rgmabs19357/Hi3520D_V100R001C01SPC022/00.hardware/board/HI3520DDMEB_VER_B_BOM.xlsx

序号 | 描述 | 数量 | 单位 | 位号
8020107 | 固体SMD钽电容-25V-47uF-+/- | 6 | PCS | C1 C2 C3 C4 C5 C27
 | 20%-片状-7.3*4.3*2.8mm-
 | 普通(0.9ohm)
8020091 | 固体SMD钽电容-10V-100uF-+/- | 1 | PCS | C6
 | 20%-片状-7.3*4.3*3.1mm-
 | Low ESR(0.055ohm)-Polymer
8070730 | SMD陶瓷电容-25V-10000nF-- | 5 | PCS | C10 C11 C147 C148 C151
 | 20%~+80%-Y5V-1206
8070601 | SMD陶瓷电容-16V-1000nF-+/- | 3 | PCS | C12 C13 C257
 | 10%-X5R-0603
8070729 | SMD陶瓷电容-10V-10000nF-+/- | 1 | PCS | C14
 | 10%-X7R-1206
8070584 | SMD陶瓷电容-6.3V-220nF-+/- | 4 | PCS | C15 C39 C40 C41
 | 10%-X5R-0402-BT
8070235 | SMD陶瓷电容-50V-0.018nF-+/- | 2 | PCS | C16 C17
 | 5%-NPO-0603
8070667 | SMD陶瓷电容-6.3V-2200nF-+/- | 9 | PCS | C18 C19 C20 C21 C22 C23
 | 20%-X5R-0402-TS16949 |  |  | C24 C25 C26
8070680 | SMD陶瓷电容-6.3V-47000nF-+/- | 1 | PCS | C28
 | 20%-X5R-1206
8070614 | SMD陶瓷电容-16V-100nF-+/- | 107 | PCS | C29 C30 C31 C32 C33 C34
 | 10%-X7R-0402-BT |  |  | C35 C36 C37 C101 C102 C103
 |  |  |  | C104 C105 C106 C107 C277 C278
 |  |  |  | C115 C116 C117 C141 C142 C160
 |  |  |  | C161 C162 C183 C184 C185 C186
 |  |  |  | C188 C192 C210 C211 C212 C213
 |  |  |  | C214 C215 C236 C92 C93 C94
 |  |  |  | C95 C96 C97 C98 C99 C100
 |  |  |  | C237 C238 C252 C265 C266 C267
 |  |  |  | C268 C108 C109 C110 C111 C112
 |  |  |  | C113 C114 C65 C66 C67 C68
 |  |  |  | C69 C70 C71 C72 C73 C74
 |  |  |  | C75 C76 C77 C78 C79 C80
 |  |  |  | C81 C82 C83 C84 C85 C86
 |  |  |  | C87 C88 C89 C90 C91 C38
 |  |  |  | C46 C47 C50 C51 C52 C53
 |  |  |  | C54 C55 C56 C57 C58 C59
 |  |  |  | C60 C61 C62 C63 C64
8071114 | SMD陶瓷电容-6.3V-22000nF-+/- | 1 | PCS | C42
 | 20%-X5R-0805-
 | 08070784编码拆分供华为技术使
8070821 | SMD陶瓷电容-6.3V-10000nF-+/- | 5 | PCS | C43 C44 C45 C284 C285
 | 20%-X5R-0603
8070564 | SMD陶瓷电容-6.3V-4700nF-+/- | 4 | PCS | C48 C49 C226 C274
 | 20%-X5R-0603-BT,TS16949
8070561 | SMD陶瓷电容-10V-100nF-+/- | 25 | PCS | C118 C119 C120 C121 C122 C123
 | 10%-X5R-0402 |  |  | C124 C140 C239 C240 C276 C132
 |  |  |  | C133 C134 C135 C136 C137 C138
 |  |  |  | C125 C126 C127 C128 C129 C130
 |  |  |  | C131
8070279 | SMD陶瓷电容-50V-0.01nF-+/- | 6 | PCS | C139 C154 C293 C294 C295 C296
 | 0.25pF-NPO-0603
8070627 | SMD陶瓷电容-50V-100nF-+/- | 9 | PCS | C143 C144 C145 C146 C149 C150
 | 10%-X7R-0603 |  |  | C255 C256 C258
8070545 | SMD陶瓷电容-50V-0.022nF-+/- | 2 | PCS | C152 C153
 | 5%-NP0-0402-BT
8070262 | SMD陶瓷电容-16V-100nF-+/- | 9 | PCS | C155 C156 C157 C158 C159 C243
 | 10%-X7R-0603-TS16949 |  |  | C244 C245 C269
8070612 | SMD陶瓷电容-10V-1000nF-+/- | 22 | PCS | C163 C164 C165 C166 C167 C168
 | 10%-X5R-0402-BT,TS16949 |  |  | C169 C177 C264 C270 C271 C272
 |  |  |  | C273 C275 C170 C171 C172 C173
 |  |  |  | C174 C175 C176 C291
8070734 | SMD陶瓷电容-6.3V-100000nF- | 1 | PCS | C178
 | +/-20%-X5R-1206-TS16949
8070461 | SMD陶瓷电容-50V-0.027nF-+/- | 2 | PCS | C179 C180
 | 5%-NPO-0603
8070531 | SMD陶瓷电容-50V-1nF-+/-10%- | 3 | PCS | C187 C246 C253
 | X7R-0402-BT
8070439 | SMD陶瓷电容-2000V-1nF-+/- | 1 | PCS | C189
 | 20%-X7R-1206
8020132 | 固体SMD钽电容-6.3V-220uF-+/- | 4 | PCS | C190 C191 C193 C283
 | 20%-片式-3.5*2.8*1.9mm-
 | Low ESR(35mohm)-Polymer-
 | 供电专用
8070565 | SMD陶瓷电容-6.3V-10000nF-+/- | 2 | PCS | C194 C195
 | 10%-X5R-0805-TS16949
8020067 | 固体SMD钽电容-10V-100uF-+/- | 3 | PCS | C196 C197 C247
 | 20%-片状-7.3*4.3*2.8mm-
 | Low ESR(0.1ohm)
8070247 | SMD陶瓷电容-50V-10nF-+/-10%- | 12 | PCS | C198 C199 C200 C201 C202 C203
 | X7R-0603-TS16949 |  |  | C204 C205 C206 C207 C208 C209
8070649 | SMD陶瓷电容-6.3V-10000nF-+/- | 20 | PCS | C216 C217 C262 C263 C287 C288
 | 20%-X5R-0603-BT,TS16949 |  |  | C225 C248 C249 C250 C251 C260
 |  |  |  | C261 C218 C219 C220 C221 C222
 |  |  |  | C223 C224
8070609 | SMD陶瓷电容-50V-1.8nF-+/- | 9 | PCS | C227 C228 C229 C230 C231 C232
 | 10%-X7R-0402 |  |  | C233 C234 C235
8070449 | SMD陶瓷电容-16V-10nF-+/-10%- | 2 | PCS | C241 C242
 | X7R-0402-BT,TS16949
8071208 | SMD陶瓷电容-6.3V-47000nF-+/- | 1 | PCS | C254
 | 20%-X5R-0805
8020120 | 固体SMD钽电容-2.5V-220uF-+/- | 2 | PCS | C279 C280
 | 20%-片状-3.5*2.8*1.9mm-
 | Low ESR(35mohm)-Polymer
8070563 | SMD陶瓷电容-6.3V-2200nF-+/- | 2 | PCS | C281 C282
 | 10%-X5R-0603-BT
8070731 | SMD陶瓷电容-25V-10000nF-+/- | 1 | PCS | C286
 | 20%-X5R-1206
8070625 | SMD陶瓷电容-6.3V-470nF-+/- | 2 | PCS | C289 C290
 | 10%-X5R-0402
8070654 | SMD陶瓷电容-6.3V-100000nF- | 1 | PCS | C292
 | +/-20%-X5R-1210
15040152 | 瞬态抑制二极管-6V-12.5V- | 8 | PCS | D1 D2 D3 D4 D5 D6 D7 D8
 | 300W-10A-SOT23
15040135 | 瞬态抑制二极管-14.2V-15.8V- | 3 | PCS | D9 D10 D11
 | 300W-0A-SOT-23
15020097 | 红外遥控接收头-2.7~5.5V- | 1 | PCS | D17
 | 0.001A-0.015km-38kHz-940nm-
 | 6.95*6.0*5.6mm-
15040173 | 瞬态抑制二极管-17.1V-25.2V- | 1 | PCS | D18
 | 1500W-59.5A-SMC(DO-214AB)
15020062 | 发光二极管-0.015cd- | 3 | PCS | D19 D23 D24
 | 红色/630nm-15mA-0805
15040241 | 瞬态抑制二极管-350V-275V- | 1 | PCS | D20
 | 100A-SMB
15010042 | 开关二极管-70V-200mA-1.25V- | 2 | PCS | D21 D22
 | 6ns-串联-SOT-23-2 FIT
15010252 | 肖特基二极管-10V-3A-0.24V- | 1 | PCS | D25
 | SOD323-BT
19040108 | 保险管套件-快熔断-125V-5A- | 1 | PCS | F1
 | UL规格-0.016ohm-5.5A*A*Sec-
 | 有
14050006 | 插针-普通方脚插针-3PIN-单排- | 1 | PCS | J1
 | 直式-5.84mm-3.9mm-2.54mm-THT
14240065 | IO连接器-4+4Pin- | 1 | PCS | J2
 | 插座/侧面插入型-屏蔽-
 | A型USB插座
14160139 | 音视频连接器-RCA莲花插座- | 2 | PCS | J3 J4
 | 2PIN-弯母-THT-
 | 黄,从14160122中拆分,环保型号
 | 华技终端专用
14060040 | 电缆连接器-D-SUB型-15PIN- | 2 | PCS | J5 J6
 | 弯母-PCB焊接型-螺母UNC4-
 | 40,引脚长3.1mm-5A
14100075 | 普通插座-4PIN-单排-直式- | 1 | PCS | J7
 | 2.5mm-2mm-THT-3A
14190002 | 电源连接器-DC头-1PIN-50V- | 1 | PCS | J8
 | 0.5A-弯式-公座-焊接
DMEB00J9 | SATA数据连接器 | 2 | PCS | J9 J10
14200041 | 插座-电缆连接器-20PIN- | 1 | PCS | J11
 | 双直插座-2.54mm-9.3mm-2.9mm-
 | THT
14060132 | 电缆连接器-D型，三排-15PIN- | 1 | PCS | J12
 | 母座，弯脚-
 | PCB焊接型,螺母规格UNC4-40-
 | 引脚长3.2mm-
14080137 | 网口连接器-单排-单端口-8PIN- | 1 | PCS | J13
 | 8bit-非屏蔽-
 | 模型插座/侧面插入型-
 | 引脚长2.54mm-带固定脚/带灯
14060033 | 电缆连接器-D-SUB型-9PIN- | 1 | PCS | J14
 | 弯公-PCB焊接型-
 | 螺母规格UNC 4-
 | 40,引脚长3.1mm-5A
14050101 | 插针-普通方脚插针-1PIN-单排- | 4 | PCS | J15 J20 J21 J22
 | 直式-5.84mm-2.92mm-2.54mm-
 | THT
DMEB0J16 | HDMI连接器 | 1 | PCS | J16
14160126 | 音视频连接器-RCA莲花插座- | 1 | PCS | J17
 | 3PIN-弯母-PCB焊接型-
 | 黑,屏蔽/终端专用
DMEB0J18 | 2X16扣板连接器 | 2 | PCS | J18 J19
14100117 | 普通插座-4PIN-单排-直式- | 1 | PCS | J23
 | 5.08mm-2mm-THT-10A-(UL94V-0)
10031094 | 贴片电感器-4.7uH-+/-30%- | 4 | PCS | L1 L2 L3 L4
 | 0.032ohm-4A-30degC max-
 | 7.0*7.0*4.0mm-
 | 使用温度范围包括电感温升
10031213 | 贴片电感器-0.15uH-5%- | 3 | PCS | L5 L6 L7
 | 0.92ohm-0.28A-15degC-0603-
10070013 | EMI磁珠-+/-25%-600ohm- | 8 | PCS | LB1 LB2 LB3 LB4 LB13 LB14
 | 0.65ohm-0.2A- |  |  | LB15 LB16
10070008 | EMI磁珠-+/25%-100ohm-0.1ohm- | 4 | PCS | LB5 LB6 LB7 LB17
 | 0.9A-0805
10070014 | EMI磁珠-25%-600ohm-0.25ohm- | 2 | PCS | LB9 LB12
 | 0.5A-TS16949
10070019 | EMI磁珠-+/-25%-1000ohm- | 3 | PCS | LB10 LB11 LB18
 | 1.25ohm-0.25A-0402-
 | 1400ohm@1GHZ
10070003 | EMI磁珠-30ohm-0.05ohm-0.4A--603 | 1 | PCS | LB19
10070007 | EMI磁珠-±30%-600ohm- | 2 | PCS | LB20 LB21
 | 0.042ohm-3A-1210
10070012 | EMI磁珠-220ohm-0.05ohm-2A-805 | 1 | PCS | LB22
12010322 | 钟振-24MHz-+-50ppm--20degC- | 1 | PCS | OSC1
 | 70degC-3.3V-C-MOS-4pin/smd
15050086 | 三极管-NPN-40V-500mA-200mW- | 3 | PCS | Q1 Q2 Q3
 | 250mV-SC-59/sot-23-50
15060143 | MOSFET-N沟道-60V-0.115A- | 2 | PCS | Q5 Q6
 | 7500mohm-20V-SOT23
7090776 | 片式厚膜电阻器-0.0625W- | 17 | PCS | R1 R2 R3 R4 R5 R6 R7 R8
 | 49.9ohm-+/-1%-0402-BT |  |  | R9 R10 R11 R12 R13 R14 R15
 |  |  |  | R16 R17
7090803 | 片式厚膜电阻器-0.0625W- | 2 | PCS | R18 R73
 | 22ohm-+/-5%-0402-BT
7090603 | 片式厚膜电阻器-0.1W-100ohm- | 1 | PCS | R19
 | +/-1%-0603
7090937 | 片式厚膜电阻器-0.1W- | 2 | PCS | R20 R21
 | 27000ohm-+/-1%-0603
7090829 | 片式厚膜电阻器-0.0625W- | 2 | PCS | R22 R23
 | 47000ohm-+/-1%-0402
7090807 | 片式厚膜电阻器-0.0625W- | 2 | PCS | R24 R25
 | 100ohm-+/-5%-0402-BT
7091238 | 片式厚膜电阻器-0.1W- | 1 | PCS | R26
 | 75000ohm-+/-1%-0603
7090840 | 片式厚膜电阻器-0.0625W- | 3 | PCS | R27 R77 R104
 | 120ohm-+/-5%-0402
7090861 | 片式厚膜电阻器-0.0625W- | 5 | PCS | R28 R29 R30 R31 R32
 | 33ohm-+/-5%-0402-ELOM
7090836 | 片式厚膜电阻器-0.0625W- | 1 | PCS | R33
 | 33ohm-+/-1%-0402
7090247 | 片式厚膜电阻器-0.1W- | 4 | PCS | R34 R35 R50 R103
 | 10000ohm-+/-5%-0603-TS16949
7090857 | 片式厚膜电阻器-0.0625W- | 1 | PCS | R36
 | 1000000ohm-+/-1%-0402
7090800 | 片式厚膜电阻器-0.0625W-0ohm- | 10 | PCS | R37 R38 R39 R41 R42 R43
 | < 50mohm-0402-1A-BT |  |  | R45 R47 R198 R199
7091372 | 片式厚膜电阻器-0.0625W- | 1 | PCS | R48
 | 15000ohm-+/-1%-0402-BT
7090809 | 片式厚膜电阻器-0.0625W- | 4 | PCS | R49 R51 R52 R53
 | 1000ohm-+/-5%-0402-BT
7090548 | 片式厚膜电阻器-0.125W- | 2 | PCS | R55 R56
 | 8200ohm-+/-1%-0805
7090817 | 片式厚膜电阻器-0.0625W- | 2 | PCS | R57 R58
 | 12000ohm-+/-1%-0402
7090631 | 片式厚膜电阻器-0.1W-191ohm- | 2 | PCS | R59 R133
 | +/-1%-0603
7090634 | 片式厚膜电阻器-0.1W-43.2ohm- | 1 | PCS | R60
 | +/-1%-0603
7090815 | 片式厚膜电阻器-0.0625W- | 6 | PCS | R61 R62 R63 R65 R100 R146
 | 10000ohm-+/-5%-0402-BT
7090831 | 片式厚膜电阻器-0.0625W- | 5 | PCS | R68 R69 R70 R71 R72
 | 100000ohm-+/-5%-0402-BT
7090793 | 片式厚膜电阻器-0.0625W- | 6 | PCS | R74 R75 R76 R127 R128 R142
 | 4700ohm-+/-5%-0402-BT
7091321 | 片式厚膜电阻器-0.0625W- | 5 | PCS | R78 R79 R80 R81 R82
 | 75ohm-+/-1%-0402
7090610 | 片式厚膜电阻器-0.0625W- | 4 | PCS | R83 R84 R85 R86
 | 51ohm-+/-5%-0402
7090497 | 片式厚膜电阻器-0.1W-160ohm- | 1 | PCS | R89
 | +/-5%-0603
7090828 | 片式厚膜电阻器-0.0625W- | 2 | PCS | R90 R91
 | 33000ohm-+/-5%-0402
7090876 | 片式厚膜电阻器-0.0625W- | 8 | PCS | R92 R93 R94 R95 R96 R97
 | 24.9ohm-+/-1%-0402 |  |  | R98 R99
7090826 | 片式厚膜电阻器-0.1W-7680ohm- | 1 | PCS | R101
 | +/-1%-0603
7090246 | 片式厚膜电阻器-0.1W-4700ohm- | 3 | PCS | R102 R116 R117
 | +/-5%-0603-TS16949
7091376 | 片式厚膜电阻器-0.0625W- | 1 | PCS | R105
 | 24000ohm-+/-1%-0402
7090637 | 片式厚膜电阻器-0.1W-75ohm- | 6 | PCS | R106 R107 R108 R109 R110 R111
 | +/-5%-0603
7090253 | 片式厚膜电阻器-0.1W- | 1 | PCS | R115
 | 47000ohm-±5%-0603
7090277 | 片式厚膜电阻器-0.1W-1000ohm- | 5 | PCS | R118 R119 R123 R124 R130
 | +/-5%-0603-TS16949
7090941 | 片式厚膜电阻器-0.1W- | 1 | PCS | R120
 | 100000ohm-+/-1%-0603
7090643 | 片式厚膜电阻器-0.1W-2000ohm- | 6 | PCS | R121 R122 R125 R126 R139 R140
 | +/-5%-0603
7090522 | 片式厚膜电阻器-0.1W-0ohm- | 11 | PCS | R131 R150 R151 R152 R153 R154
 | <50mohm-0603-1A-BT,TS16949 |  |  | R155 R160 R161 R162 R163
7091421 | 片式厚膜电阻器-2W-0.001ohm- | 2 | PCS | R132 R149
 | +/-0.5%-2512-供电专用
7091641 | 片式厚膜电阻器-0.0625W- | 1 | PCS | R134
 | 39000ohm-+/-5%-0402--
 | 供电专用 07090912-供电专用
7091282 | 片式厚膜电阻器-0.0625W- | 4 | PCS | R135 R136 R137 R138
 | 1000ohm-+/-1%-0402-BT
7090784 | 片式厚膜电阻器-0.1W-2490ohm- | 1 | PCS | R145
 | +/-1%-0603
7090378 | 片式厚膜电阻器-0.1W-3010ohm- | 1 | PCS | R156
 | +/-1%-0603
7091782 | 片式厚膜电阻器-0.0625W- | 1 | PCS | R158
 | 240ohm-+/-1%-0402-BT
7090798 | 片式厚膜电阻器-0.0625W- | 4 | PCS | R159 R164 R165 R166
 | 22000ohm-+/-1%-0402
7090805 | 片式厚膜电阻器-0.0625W- | 4 | PCS | R170 R189 R193 R194
 | 47ohm-+/-5%-0402
7090266 | 片式厚膜电阻器-0.1W-51ohm- | 3 | PCS | R171 R172 R185
 | +/-5%-0603
7090821 | 片式厚膜电阻器-0.0625W- | 4 | PCS | R173 R174 R175 R176
 | 120000ohm-±5%-0402
7091388 | 片式厚膜电阻器-0.0625W- | 2 | PCS | R177 R178
 | 82000ohm-+/-1%-0402
7091345 | 片式厚膜电阻器-0.0625W- | 1 | PCS | R179
 | 750ohm-+/-1%-0402
7090269 | 片式厚膜电阻器-0.1W-100ohm- | 4 | PCS | R180 R181 R182 R183
 | +/-5%-0603
7090935 | 片式厚膜电阻器-0.1W- | 1 | PCS | R184
 | 40200ohm-+/-1%-0603
7090730 | 片式厚膜电阻器-0.0625W- | 1 | PCS | R186
 | 10ohm-+/-5%-0402
7090949 | 片式厚膜电阻器-0.1W-49.9ohm- | 1 | PCS | R187
 | +/-1%-0603
7091271 | 片式厚膜电阻器-0.0625W- | 1 | PCS | R188
 | 11000ohm-+/-1%-0402-BT
7091294 | 片式厚膜电阻器-0.1W-390ohm- | 1 | PCS | R190
 | +/-1%-0603
7090843 | 片式厚膜电阻器-0.0625W- | 2 | PCS | R195 R196
 | 470ohm-±5％-0402
7090531 | 片式厚膜电阻器-0.1W- | 1 | PCS | R197
 | 30100ohm-+/-1%-0603
7090275 | 片式厚膜电阻器-0.1W-470ohm- | 1 | PCS | R282
 | ±5%-0603
7080134 | 电阻网络-0.0625W-22ohm-4- | 4 | PCS | RN1 RN2 RN3 RN4
 | 8PIN-+/-5%-SMT-独立式-SMT-
 | 2*1*0.45-0.5mm
7080125 | 电阻网络-0.0625W-51ohm-4个- | 5 | PCS | RN5 RN6 RN7 RN8 RN9
 | 8PIN-+/-5%-SMT-小型-独立式-
 | 2.0*1.0*0.45-0.5mm
16100017 | 微动开关-SPST-12VDC-0.05A- | 1 | PCS | S1
 | SMT-0mm-6*6*5mm-100,000
9050085 | LAN变压器-1CT:1CT-0.35mH- | 1 | PCS | T1
 | 0uH-1路-2-100BASE-T接口模块-
 | SMT
39110429 | LDO-可调型-1%-TO-252&DPAK | 1 | PCS | U1
39070039 | Voltage Monitor-2.63V-220ms- | 1 | PCS | U2
 | 电压监测-1V-5.5V-SOT23-3-
 | push-pull output-终端专用
99051CSG | 单端HDMI传输保护接口器件 | 1 | PCS | U3
14190188 | 电源连接器-电池连接器-2PIN- | 1 | PCS | U4
 | 3V-0.265A-卧式-SMT
DMEB00U5 | SPI FLASH 16Mbit MX25L12835F | 1 | PCS | U5
38090077 | RS485｜422- | 1 | PCS | U6
 | RS485/422接口收发器-3.3V-
 | 12MB/s-SOIC8
99051CDK | video buff FM6143 | 1 | PCS | U7
DMEB00U8 | 主芯片HI3520D | 1 | PCS | U8
DMEB00U9 | AD芯片CX26828 | 1 | PCS | U9
40020109 | DDR3 DRAM-2Gbit-800MHz- | 1 | PCS | U10
 | 16bit-1.5V-FBGA96(无铅)
38090076 | RS232-2路收发器-3.0V~5.5V- | 1 | PCS | U11
 | SSOP16-0.25MB/s
99051MTD | MP1494DJ-LF-P | 3 | PCS | U14 U15 U12
12020001 | 晶体谐振器-0.032768MHz- | 1 | PCS | X1
 | 12.5pF-+/-20ppm-35000ohm-DT-38
12020090 | 晶体谐振器-24MHz-20pF-+/- | 1 | PCS | X2
 | 30ppm-40ohm-SMD
99051JTC | MP1495DJ-LF-P | 1 | PCS | U13
90010045 | 固体生产辅料-镀锡铜线- | 1 | CM | X1
 | D0.5mm-固定元件
无 | 印刷PCB-HI3520DDMEB VER.B | 1 | PCS | 无
