rgmabs19357/Hi3520D_V100R001C01SPC022/00.hardware/board/HI3520DDMEB_VER_B_BOM_EN.xlsx

SN | Description | Quantity | Position ID
8020107 | Solid SMD tantalum capacitor-25 V-47 uF-± | 6 | C1 C2 C3 C4 C5 C27
 | 20%-chip form-7.3 mm x 4.3 mm x 2.8 mm-
 | common (0.9 ohm)
8020091 | Solid SMD tantalum capacitor-10 V-100 uF-± | 1 | C6
 | 20%-chip form-7.3 mm x 4.3 mm x 3.1 mm-
 | Low ESR (0.055 ohm)-Polymer
8070730 | SMD ceramic capacitor-25 V-10000 nF-- | 5 | C10 C11 C147 C148 C151
 | 20% to +80%-Y5 V-1206
8070601 | SMD ceramic capacitor-16 V-1000 nF-± | 3 | C12 C13 C257
 | 10%-X5R-0603
8070729 | SMD ceramic capacitor-10 V-10000 nF-± | 1 | C14
 | 10%-X7R-1206
8070584 | SMD ceramic capacitor-6.3 V-220 nF-± | 4 | C15 C39 C40 C41
 | 10%-X5R-0402-BT
8070235 | SMD ceramic capacitor-50 V-0.018 nF-± | 2 | C16 C17
 | 5%-NPO-0603
8070667 | SMD ceramic capacitor-6.3 V-2200 nF-± | 9 | C18 C19 C20 C21 C22 C23
 | 20%-X5R-0402-TS16949 |  | C24 C25 C26
8070680 | SMD ceramic capacitor-6.3 V-47000 nF-± | 1 | C28
 | 20%-X5R-1206
8070614 | SMD ceramic capacitor-16 V-100 nF-± | 107 | C29 C30 C31 C32 C33 C34
 | 10%-X7R-0402-BT |  | C35 C36 C37 C101 C102 C103
 |  |  | C104 C105 C106 C107 C277 C278
 |  |  | C115 C116 C117 C141 C142 C160
 |  |  | C161 C162 C183 C184 C185 C186
 |  |  | C188 C192 C210 C211 C212 C213
 |  |  | C214 C215 C236 C92 C93 C94
 |  |  | C95 C96 C97 C98 C99 C100
 |  |  | C237 C238 C252 C265 C266 C267
 |  |  | C268 C108 C109 C110 C111 C112
 |  |  | C113 C114 C65 C66 C67 C68
 |  |  | C69 C70 C71 C72 C73 C74
 |  |  | C75 C76 C77 C78 C79 C80
 |  |  | C81 C82 C83 C84 C85 C86
 |  |  | C87 C88 C89 C90 C91 C38
 |  |  | C46 C47 C50 C51 C52 C53
 |  |  | C54 C55 C56 C57 C58 C59
 |  |  | C60 C61 C62 C63 C64
8071114 | SMD ceramic capacitor-6.3 V-22000 nF-± | 1 | C42
 | 20%-X5R-0805-
 | split from 08070784 for Huawei
8070821 | SMD ceramic capacitor-6.3 V-10000 nF-± | 5 | C43 C44 C45 C284 C285
 | 20%-X5R-0603
8070564 | SMD ceramic capacitor-6.3 V-4700 nF-± | 4 | C48 C49 C226 C274
 | 20%-X5R-0603-BT, TS16949
8070561 | SMD ceramic capacitor-10 V-100 nF-± | 25 | C118 C119 C120 C121 C122 C123
 | 10%-X5R-0402 |  | C124 C140 C239 C240 C276 C132
 |  |  | C133 C134 C135 C136 C137 C138
 |  |  | C125 C126 C127 C128 C129 C130
 |  |  | C131
8070279 | SMD ceramic capacitor-50 V-0.01 nF-± | 6 | C139 C154 C293 C294 C295 C296
 | 0.25pF-NPO-0603
8070627 | SMD ceramic capacitor-50 V-100 nF-± | 9 | C143 C144 C145 C146 C149 C150
 | 10%-X7R-0603 |  | C255 C256 C258
8070545 | SMD ceramic capacitor-50 V-0.022 nF-± | 2 | C152 C153
 | 5%-NP0-0402-BT
8070262 | SMD ceramic capacitor-16 V-100 nF-± | 9 | C155 C156 C157 C158 C159 C243
 | 10%-X7R-0603-TS16949 |  | C244 C245 C269
8070612 | SMD ceramic capacitor-10 V-1000 nF-± | 22 | C163 C164 C165 C166 C167 C168
 | 10%-X5R-0402-BT, TS16949 |  | C169 C177 C264 C270 C271 C272
 |  |  | C273 C275 C170 C171 C172 C173
 |  |  | C174 C175 C176 C291
8070734 | SMD ceramic capacitor-6.3 V-100000 nF- | 1 | C178
 | ±20%-X5R-1206-TS16949
8070461 | SMD ceramic capacitor-50 V-0.027 nF-± | 2 | C179 C180
 | 5%-NPO-0603
8070531 | SMD ceramic capacitor-50 V-1 nF-±10%- | 3 | C187 C246 C253
 | X7R-0402-BT
8070439 | SMD ceramic capacitor-2000 V-1 nF-± | 1 | C189
 | 20%-X7R-1206
8020132 | Solid SMD tantalum capacitor-6.3 V-220 uF-± | 4 | C190 C191 C193 C283
 | 20%-chip form-3.5 mm x 2.8 mm x 1.9 mm-
 | Low ESR (35 Mohms)-Polymer-
 | only for power supply
8070565 | SMD ceramic capacitor-6.3 V-10000 nF-± | 2 | C194 C195
 | 10%-X5R-0805-TS16949
8020067 | Solid SMD tantalum capacitor-10 V-100 uF-± | 3 | C196 C197 C247
 | 20%-chip form-7.3 mm x 4.3 mm x 2.8 mm-
 | Low ESR (0.1 ohm)
8070247 | SMD ceramic capacitor-50 V-10 nF-±10%- | 12 | C198 C199 C200 C201 C202 C203
 | X7R-0603-TS16949 |  | C204 C205 C206 C207 C208 C209
8070649 | SMD ceramic capacitor-6.3 V-10000 nF-± | 20 | C216 C217 C262 C263 C287 C288
 | 20%-X5R-0603-BT, TS16949 |  | C225 C248 C249 C250 C251 C260
 |  |  | C261 C218 C219 C220 C221 C222
 |  |  | C223 C224
8070609 | SMD ceramic capacitor-50 V-1.8 nF-± | 9 | C227 C228 C229 C230 C231 C232
 | 10%-X7R-0402 |  | C233 C234 C235
8070449 | SMD ceramic capacitor-16 V-10 nF-±10%- | 2 | C241 C242
 | X7R-0402-BT, TS16949
8071208 | SMD ceramic capacitor-6.3 V-47000 nF-± | 1 | C254
 | 20%-X5R-0805
8020120 | Solid SMD tantalum capacitor-2.5 V-220 uF-± | 2 | C279 C280
 | 20%-chip form-3.5 mm x 2.8 mm x 1.9 mm-
 | Low ESR (35 Mohms)-Polymer
8070563 | SMD ceramic capacitor-6.3 V-2200 nF-± | 2 | C281 C282
 | 10%-X5R-0603-BT
8070731 | SMD ceramic capacitor-25 V-10000 nF-± | 1 | C286
 | 20%-X5R-1206
8070625 | SMD ceramic capacitor-6.3 V-470 nF-± | 2 | C289 C290
 | 10%-X5R-0402
8070654 | SMD ceramic capacitor-6.3 V-100000 nF- | 1 | C292
 | ±20%-X5R-1210
15040152 | Transient suppression diode-6 V-12.5 V- | 8 | D1 D2 D3 D4 D5 D6 D7 D8
 | 300 W-10 A-SOT23
15040135 | Transient suppression diode-14.2 V-15.8 V- | 3 | D9 D10 D11
 | 300 W-0 A-SOT-23
15020097 | IR remote receiver-2.7 V to 5.5 V- | 1 | D17
 | 0.001 A-0.015 km-38 kHz-940 nm-
 | 6.95 mm x 6.0 mm x 5.6 mm-
15040173 | Transient suppression diode-17.1 V-25.2 V- | 1 | D18
 | 1500 W-59.5 A-SMC (DO-214 AB)
15020062 | Light emitting diode-0.015cd- | 3 | D19 D23 D24
 | red/630 nm-15 mA-0805
15040241 | Transient suppression diode-350 V-275 V- | 1 | D20
 | 100 A-SMB
15010042 | Switch diode-70 V-200 mA-1.25 V- | 2 | D21 D22
 | 6 ns-serial-SOT-23-2 FIT
15010252 | Schottky diode-10 V-3 A-0.24 V- | 1 | D25
 | SOD323-BT
19040108 | Fuse kit-fast fuse-125 V-5 A- | 1 | F1
 | UL specifications-0.016 ohm-5.5 A*A*Sec-
 | provided
14050006 | Pin-common quad pin-3-pin-single-row- | 1 | J1
 | in-line-5.84 mm-3.9 mm-2.54 mm-THT
14240065 | I/O connector-4+4-pin- | 1 | J2
 | connector/side entry-shield-
 | type-A USB connector
14160139 | Audio/Video connector-RCA connector- | 2 | J3 J4
 | 2-pin-right angle female-THT-
 | yellow, split from 14160122, environmental protection
 | dedicated for Huawei Device
14060040 | Cable connector-D-SUB type-15-pin- | 2 | J5 J6
 | right angle female-PCB soldering-nut UNC4-
 | 40, pin length of 3.1 mm-5 A
14100075 | Common connector-4-pin-single-row-in-line- | 1 | J7
 | 2.5 mm-2 mm-THT-3 A
14190002 | Power connector-DC header-1-pin-50 V- | 1 | J8
 | 0.5 A-right angle-male socket-soldering
DMEB00J9 | SATA data connector | 2 | J9 J10
14200041 | Connector-cable connector-20-pin- | 1 | J11
 | Dual-in-line connector-2.54 mm-9.3 mm-2.9 mm-
 | THT
14060132 | Cable connector-D type, three-row-15-pin- | 1 | J12
 | female connector, right angle-
 | PCB soldering, nut specifications UNC4-40-
 | pin length of 3.2 mm-
14080137 | Ethernet port connector-single-row-single-port-8-pin- | 1 | J13
 | 8-bit-non-shield-
 | model connector/side entry-
 | pin length of 2.54 mm-with fixing foot/indicator
14060033 | Cable connector-D-SUB type-9-pin- | 1 | J14
 | right angle male-PCB soldering-
 | nut specifications UNC 4-
 | 40, pin length of 3.1 mm-5 A
14050101 | Pin-common quad pin-1-pin-single-row- | 4 | J15 J20 J21 J22
 | in-line-5.84 mm-2.92 mm-2.54 mm-
 | THT
DMEB0J16 | HDMI connector | 1 | J16
14160126 | Audio/Video connector-RCA connector- | 1 | J17
 | 3-pin-right angle female-PCB soldering-
 | black, shield/dedicated for Huawei Device
DMEB0J18 | 2X16 daughter board connector | 2 | J18 J19
14100117 | Common connector-4-pin-single-row-in-line- | 1 | J23
 | 5.08 mm-2 mm-THT-10 A-(UL94 V-0)
10031094 | SMT inductor-4.7 uH-±30%- | 4 | L1 L2 L3 L4
 | 0.032 ohm-4 A-30ºC max-
 | 7.0 mm x 7.0 mm x 4.0 mm-
 | The working temperature range includes the risen temperature of the inductor.
10031213 | SMT inductor-0.15 uH-5%- | 3 | L5 L6 L7
 | 0.92 ohm-0.28 A-15ºC-0603-
10070013 | EMI bead-±25%-600 ohms- | 8 | LB1 LB2 LB3 LB4 LB13 LB14
 | 0.65 ohm-0.2 A- |  | LB15 LB16
10070008 | EMI bead-+/25%-100 ohms-0.1 ohm- | 4 | LB5 LB6 LB7 LB17
 | 0.9 A-0805
10070014 | EMI bead-25%-600 ohms-0.25 ohm- | 2 | LB9 LB12
 | 0.5 A-TS16949
10070019 | EMI bead-±25%-1000 ohms- | 3 | LB10 LB11 LB18
 | 1.25 ohm-0.25 A-0402-
 | 1400 ohms@1 GHz
10070003 | EMI bead-30 ohm-0.05 ohm-0.4 A--603 | 1 | LB19
10070007 | EMI bead-±30%-600 ohms- | 2 | LB20 LB21
 | 0.042 ohm-3 A-1210
10070012 | EMI bead-220 ohm-0.05 ohm-2 A-805 | 1 | LB22
12010322 | Clock oscillator-24 MHz-±50 ppm--20ºC- | 1 | OSC1
 | 70ºC-3.3 V-C-MOS-4-pin/smd
15050086 | Triode-NPN-40 V-500 mA-200mW- | 3 | Q1 Q2 Q3
 | 250 mV-SC-59/sot-23-50
15060143 | MOSFET-N channel-60 V-0.115 A- | 2 | Q5 Q6
 | 7500 Mohms-20 V-SOT23
7090776 | Thick film chip resistor-0.0625 W- | 17 | R1 R2 R3 R4 R5 R6 R7 R8
 | 49.9 ohms-±1%-0402-BT |  | R9 R10 R11 R12 R13 R14 R15
 |  |  | R16 R17
7090803 | Thick film chip resistor-0.0625 W- | 2 | R18 R73
 | 22 ohm-±5%-0402-BT
7090603 | Thick film chip resistor-0.1 W-100 ohms- | 1 | R19
 | ±1%-0603
7090937 | Thick film chip resistor-0.1 W- | 2 | R20 R21
 | 27000 ohms-±1%-0603
7090829 | Thick film chip resistor-0.0625 W- | 2 | R22 R23
 | 47000 ohms-±1%-0402
7090807 | Thick film chip resistor-0.0625 W- | 2 | R24 R25
 | 100 ohms-±5%-0402-BT
7091238 | Thick film chip resistor-0.1 W- | 1 | R26
 | 75000 ohms-±1%-0603
7090840 | Thick film chip resistor-0.0625 W- | 3 | R27 R77 R104
 | 120 ohm-±5%-0402
7090861 | Thick film chip resistor-0.0625 W- | 5 | R28 R29 R30 R31 R32
 | 33 ohm-±5%-0402-ELOM
7090836 | Thick film chip resistor-0.0625 W- | 1 | R33
 | 33 ohm-±1%-0402
7090247 | Thick film chip resistor-0.1 W- | 4 | R34 R35 R50 R103
 | 10000 ohms-±5%-0603-TS16949
7090857 | Thick film chip resistor-0.0625 W- | 1 | R36
 | 1000000 ohms-±1%-0402
7090800 | Thick film chip resistor-0.0625 W-0 ohms- | 10 | R37 R38 R39 R41 R42 R43
 | < 50 Mohms-0402-1 A-BT |  | R45 R47 R198 R199
7091372 | Thick film chip resistor-0.0625 W- | 1 | R48
 | 15000 ohms-±1%-0402-BT
7090809 | Thick film chip resistor-0.0625 W- | 4 | R49 R51 R52 R53
 | 1000 ohms-±5%-0402-BT
7090548 | Thick film chip resistor-0.125 W- | 2 | R55 R56
 | 8200 ohms-±1%-0805
7090817 | Thick film chip resistor-0.0625 W- | 2 | R57 R58
 | 12000 ohms-±1%-0402
7090631 | Thick film chip resistor-0.1 W-191 ohms- | 2 | R59 R133
 | ±1%-0603
7090634 | Thick film chip resistor-0.1 W-43.2 ohms- | 1 | R60
 | ±1%-0603
7090815 | Thick film chip resistor-0.0625 W- | 6 | R61 R62 R63 R65 R100 R146
 | 10000 ohms-±5%-0402-BT
7090831 | Thick film chip resistor-0.0625 W- | 5 | R68 R69 R70 R71 R72
 | 100000 ohms-±5%-0402-BT
7090793 | Thick film chip resistor-0.0625 W- | 6 | R74 R75 R76 R127 R128 R142
 | 4700 ohms-±5%-0402-BT
7091321 | Thick film chip resistor-0.0625 W- | 5 | R78 R79 R80 R81 R82
 | 75 ohms-±1%-0402
7090610 | Thick film chip resistor-0.0625 W- | 4 | R83 R84 R85 R86
 | 51 ohms-±5%-0402
7090497 | Thick film chip resistor-0.1 W-160 ohms- | 1 | R89
 | ±5%-0603
7090828 | Thick film chip resistor-0.0625 W- | 2 | R90 R91
 | 33000 ohms-±5%-0402
7090876 | Thick film chip resistor-0.0625 W- | 8 | R92 R93 R94 R95 R96 R97
 | 24.9 ohms-±1%-0402 |  | R98 R99
7090826 | Thick film chip resistor-0.1 W-7680 ohms- | 1 | R101
 | ±1%-0603
7090246 | Thick film chip resistor-0.1 W-4700 ohms- | 3 | R102 R116 R117
 | ±5%-0603-TS16949
7091376 | Thick film chip resistor-0.0625 W- | 1 | R105
 | 24000 ohms-±1%-0402
7090637 | Thick film chip resistor-0.1 W-75 ohms- | 6 | R106 R107 R108 R109 R110 R111
 | ±5%-0603
7090253 | Thick film chip resistor-0.1 W- | 1 | R115
 | 47000 ohms-±5%-0603
7090277 | Thick film chip resistor-0.1 W-1000 ohms- | 5 | R118 R119 R123 R124 R130
 | ±5%-0603-TS16949
7090941 | Thick film chip resistor-0.1 W- | 1 | R120
 | 100000 ohms-±1%-0603
7090643 | Thick film chip resistor-0.1 W-2000 ohms- | 6 | R121 R122 R125 R126 R139 R140
 | ±5%-0603
7090522 | Thick film chip resistor-0.1 W-0 ohms- | 11 | R131 R150 R151 R152 R153 R154
 | <50 Mohms-0603-1 A-BT, TS16949 |  | R155 R160 R161 R162 R163
7091421 | Thick film chip resistor-2 W-0.001 ohm- | 2 | R132 R149
 | ±0.5%-2512-only for power supply
7091641 | Thick film chip resistor-0.0625 W- | 1 | R134
 | 39000 ohms-±5%-0402--
 | only for power supply 07090912-only for power supply
7091282 | Thick film chip resistor-0.0625 W- | 4 | R135 R136 R137 R138
 | 1000 ohms-±1%-0402-BT
7090784 | Thick film chip resistor-0.1 W-2490 ohms- | 1 | R145
 | ±1%-0603
7090378 | Thick film chip resistor-0.1 W-3010 ohms- | 1 | R156
 | ±1%-0603
7091782 | Thick film chip resistor-0.0625 W- | 1 | R158
 | 240 ohms-±1%-0402-BT
7090798 | Thick film chip resistor-0.0625 W- | 4 | R159 R164 R165 R166
 | 22000 ohms-±1%-0402
7090805 | Thick film chip resistor-0.0625 W- | 4 | R170 R189 R193 R194
 | 47 ohm-±5%-0402
7090266 | Thick film chip resistor-0.1 W-51 ohm- | 3 | R171 R172 R185
 | ±5%-0603
7090821 | Thick film chip resistor-0.0625 W- | 4 | R173 R174 R175 R176
 | 120000 ohms-±5%-0402
7091388 | Thick film chip resistor-0.0625 W- | 2 | R177 R178
 | 82000 ohms-±1%-0402
7091345 | Thick film chip resistor-0.0625 W- | 1 | R179
 | 750 ohms-±1%-0402
7090269 | Thick film chip resistor-0.1 W-100 ohms- | 4 | R180 R181 R182 R183
 | ±5%-0603
7090935 | Thick film chip resistor-0.1 W- | 1 | R184
 | 40200 ohms-±1%-0603
7090730 | Thick film chip resistor-0.0625 W- | 1 | R186
 | 10 ohms-±5%-0402
7090949 | Thick film chip resistor-0.1 W-49.9 ohms- | 1 | R187
 | ±1%-0603
7091271 | Thick film chip resistor-0.0625 W- | 1 | R188
 | 11000 ohms-±1%-0402-BT
7091294 | Thick film chip resistor-0.1 W-390 ohms- | 1 | R190
 | ±1%-0603
7090843 | Thick film chip resistor-0.0625 W- | 2 | R195 R196
 | 470 ohm-±5%-0402
7090531 | Thick film chip resistor-0.1 W- | 1 | R197
 | 30100 ohms-±1%-0603
7090275 | Thick film chip resistor-0.1 W-470 ohms- | 1 | R282
 | ±5%-0603
7080134 | Resistor network-0.0625 W-22 ohms-4- | 4 | RN1 RN2 RN3 RN4
 | 8-pin-±5%-SMT-independent-SMT-
 | 2 x 1 x 0.45-0.5 mm
7080125 | Resistor network-0.0625 W-51 ohm-4- | 5 | RN5 RN6 RN7 RN8 RN9
 | 8PIN-±5%-SMT-mini-type-independent-
 | 2.0 x 1.0 x 0.45-0.5 mm
16100017 | Microswitch-SPST-12 VDC-0.05 A- | 1 | S1
 | SMT-0 mm-6 mm x 6 mm x 5 mm-100,000
9050085 | LAN transformer-1CT:1CT-0.35 mH- | 1 | T1
 | 0 uH-1-channel-2-100BASE-T interface module-
 | SMT
39110429 | LDO-adjustable-1%-TO-252&DPAK | 1 | U1
39070039 | Voltage monitor-2.63 V-220 ms- | 1 | U2
 | voltage monitoring-1 V-5.5 V-SOT23-3-
 | push-pull output-dedicated for Huawei Device
99051CSG | Single-end HDMI transfer protective component | 1 | U3
14190188 | Power connector-battery connector-2-pin- | 1 | U4
 | 3 V-0.265 A-horizontal type-SMT
DMEB00U5 | SPI flash 16-Mbit MX25L12835F | 1 | U5
38090077 | RS485|422- | 1 | U6
 | RS485/422 interface transceiver-3.3 V-
 | 12 MB/s-SOIC8
99051CDK | video buffer FM6143 | 1 | U7
DMEB00U8 | Master chip Hi3520D | 1 | U8
DMEB00U9 | ADC CX26828 | 1 | U9
40020109 | DDR3 DRAM-2 Gbits-800 MHz- | 1 | U10
 | 16-bit-1.5 V-FBGA96 (lead free)
38090076 | RS232-2-channel transceiver-3.0 V to 5.5 V- | 1 | U11
 | SSOP16-0.25 MB/s
99051MTD | MP1494DJ-LF-P | 3 | U14 U15 U12
12020001 | Crystal resonator-0.032768 MHz- | 1 | X1
 | 12.5 pF-±20 ppm-35000 ohms-DT-38
12020090 | Crystal resonator-24 MHz-20 pF-± | 1 | X2
 | 30 ppm-40 ohm-SMD
99051JTC | MP1495DJ-LF-P | 1 | U13
90010045 | Auxiliary solid material-tinned copper wire- | 1 | X1
 | D0.5 mm-fixing component
None | PCB-Hi3520D DMEB VER.B | 1 | None
