rgmabs19357/Hi3520D_V100R001C01SPC022/00.hardware/board/Hi3520DDMEB_VER_B.pdf

1 | 2 | 3 | 4 | 5 | 6

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
2 | 3 | 4 | 5 | 6
| | REVIEWED

### DESIGNED

HUAWEI TECH CO.,LTD.

## VER PART_NUMBER

## The type and specification of the components refer to the BOM

ECA NO | DATE
SHEET | OF

# 2.BLOCK DIAGRAM

# 1.Hi3520DDMEB VER.B

# Hi3520DDMEB Ver.B

# 5.POWER SUPPLY1 6.POWER SUPPLY2 7.Hi3520D POWER_GND 8.Hi3520D DDR3 9.Hi3520D SYS_RST_JTAG 10.JTAG & RS232 & RS485 & ETH & RTC 11.Interface 12.Display 13.HDMI

14.VI
15.CX26828

# 16.Backboard 17.Backboard

# 3.POWER TREE 4.CHANGE LIST

B 03030001

# HI3520DDMEB

### YUJIANHONG 00181445

### LISI XXXXX

NA

00001234

17

A

A

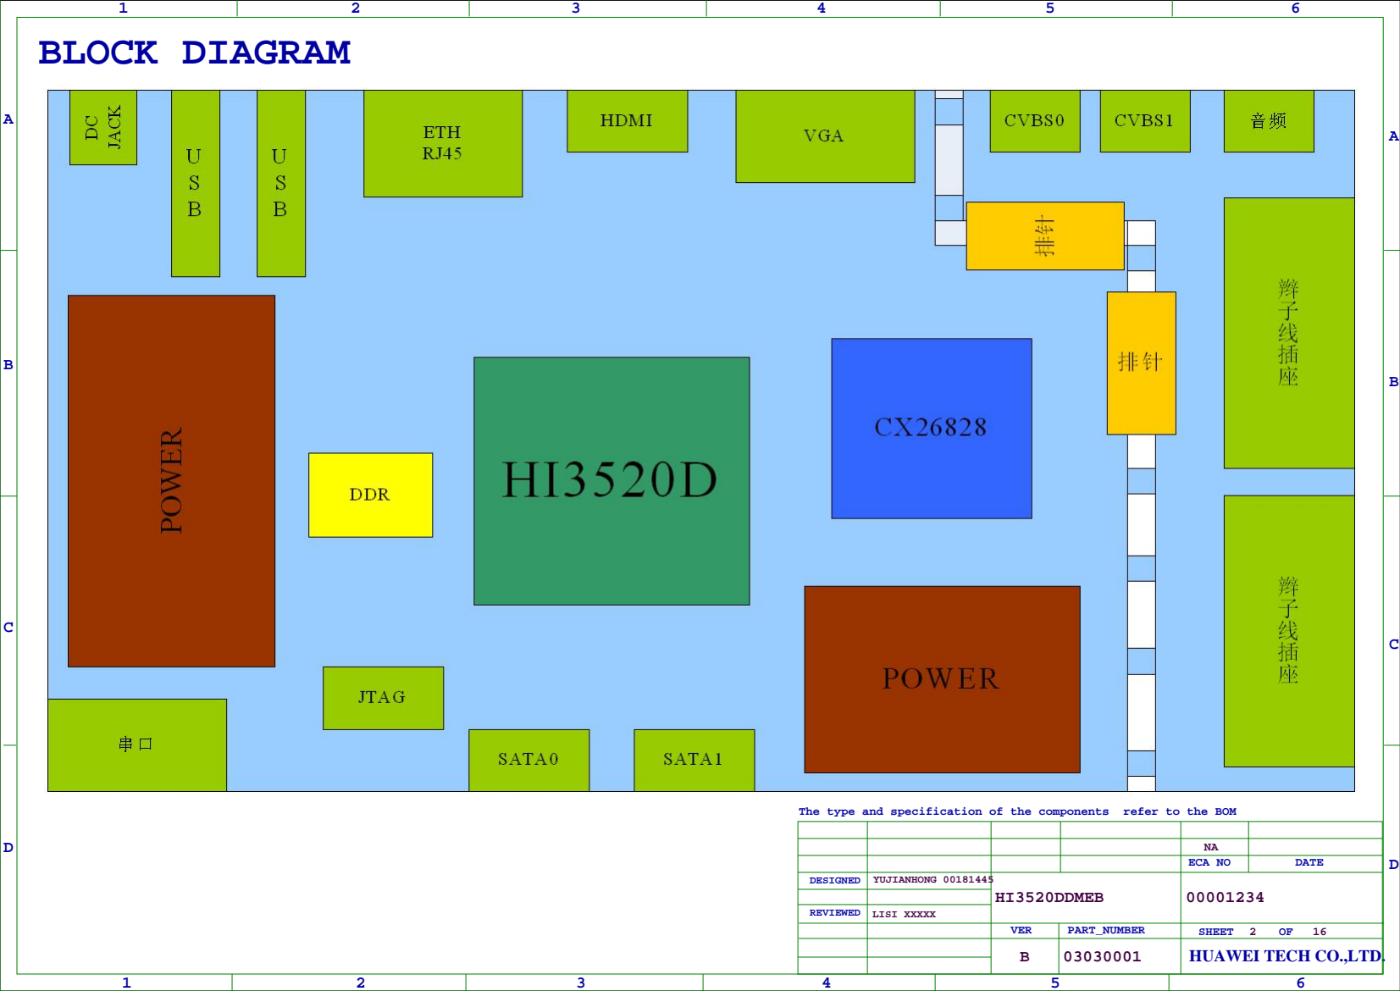
[picture p1: page 2]

D

B

C

D

B

C

### DESIGNED

## The type and specification of the components refer to the BOM

ECA NO | DATE

# BLOCK DIAGRAM

# HI3520DDMEB

### YUJIANHONG 00181445

2

NA

00001234

16

A

A

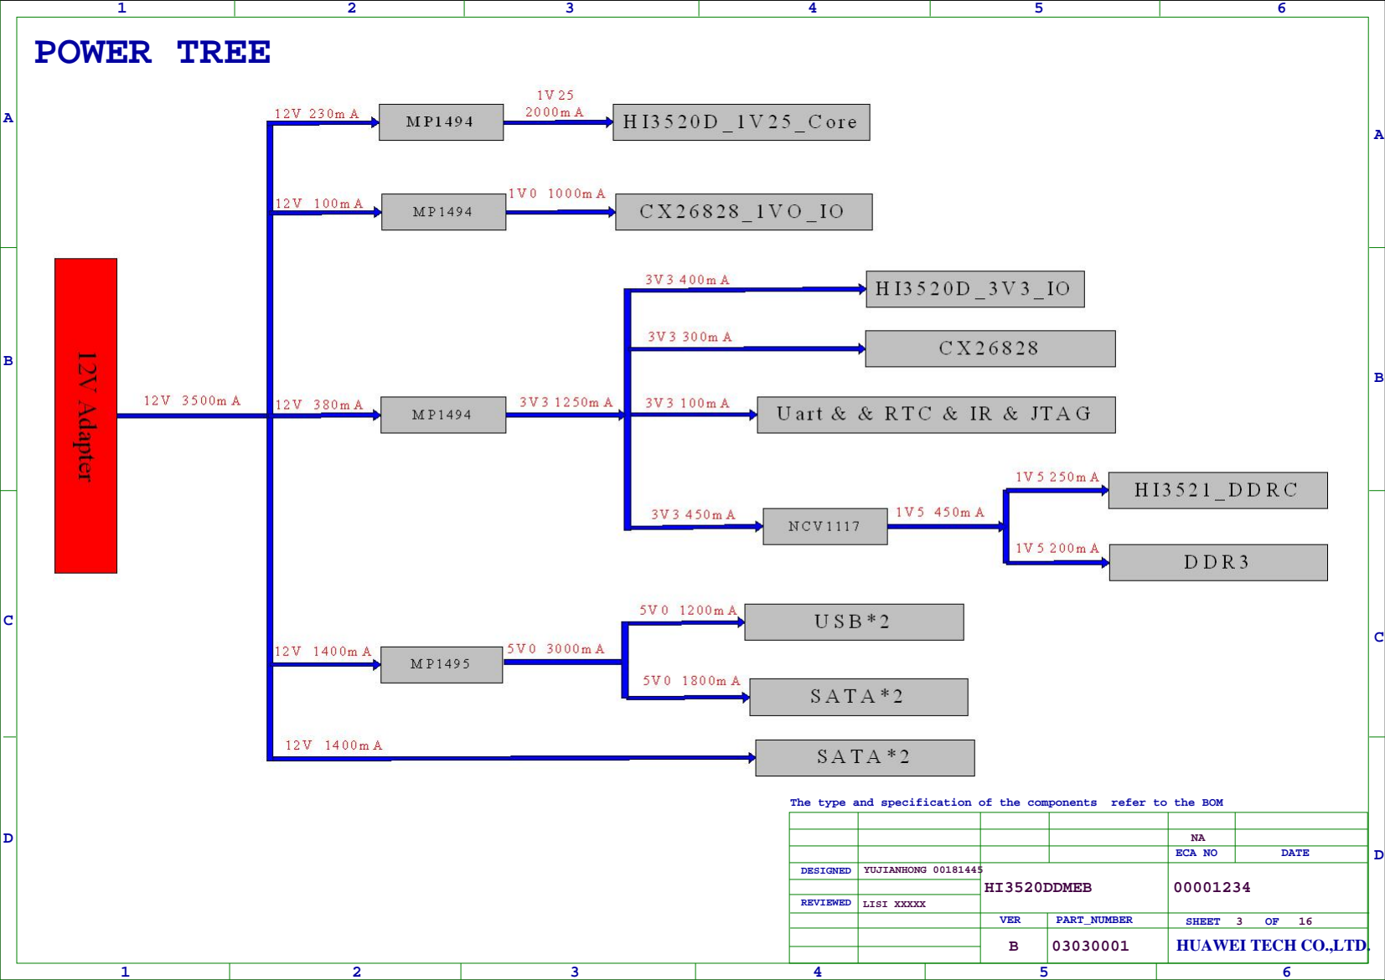
[picture p2: page 3]

D

B

C

D

B

C

### DESIGNED

## The type and specification of the components refer to the BOM

ECA NO | DATE

# POWER TREE

# HI3520DDMEB

### YUJIANHONG 00181445

3

NA

00001234

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
### DESIGNED

## The type and specification of the components refer to the BOM

ECA NO | DATE

# Change list

2013.01.01 Ver.A schematic.

2013.04.21 Ver.B schematic.

# 1)Updata VDAC RETX value.Change R59 from 200R to 191R,change R156 from NC to 3.01K 2)Change C257 from 100nF to 1uF 3)Change R179 from 158R to 750R.Change R89 from 750R to 160R 4)Updata HDMI REXT value.Change R188 from 6.8K to 11K.Change R134 from 51K to 39K

# 6)Add JTAG_SEL select

# 7)Add External RTC circuit.This circuit has not been modified in the PCB

# 5)Add LPF to the VGA_RGB output(NC in the SCH & PCB )

# HI3520DDMEB

### YUJIANHONG 00181445

4

NA

00001234

A

A

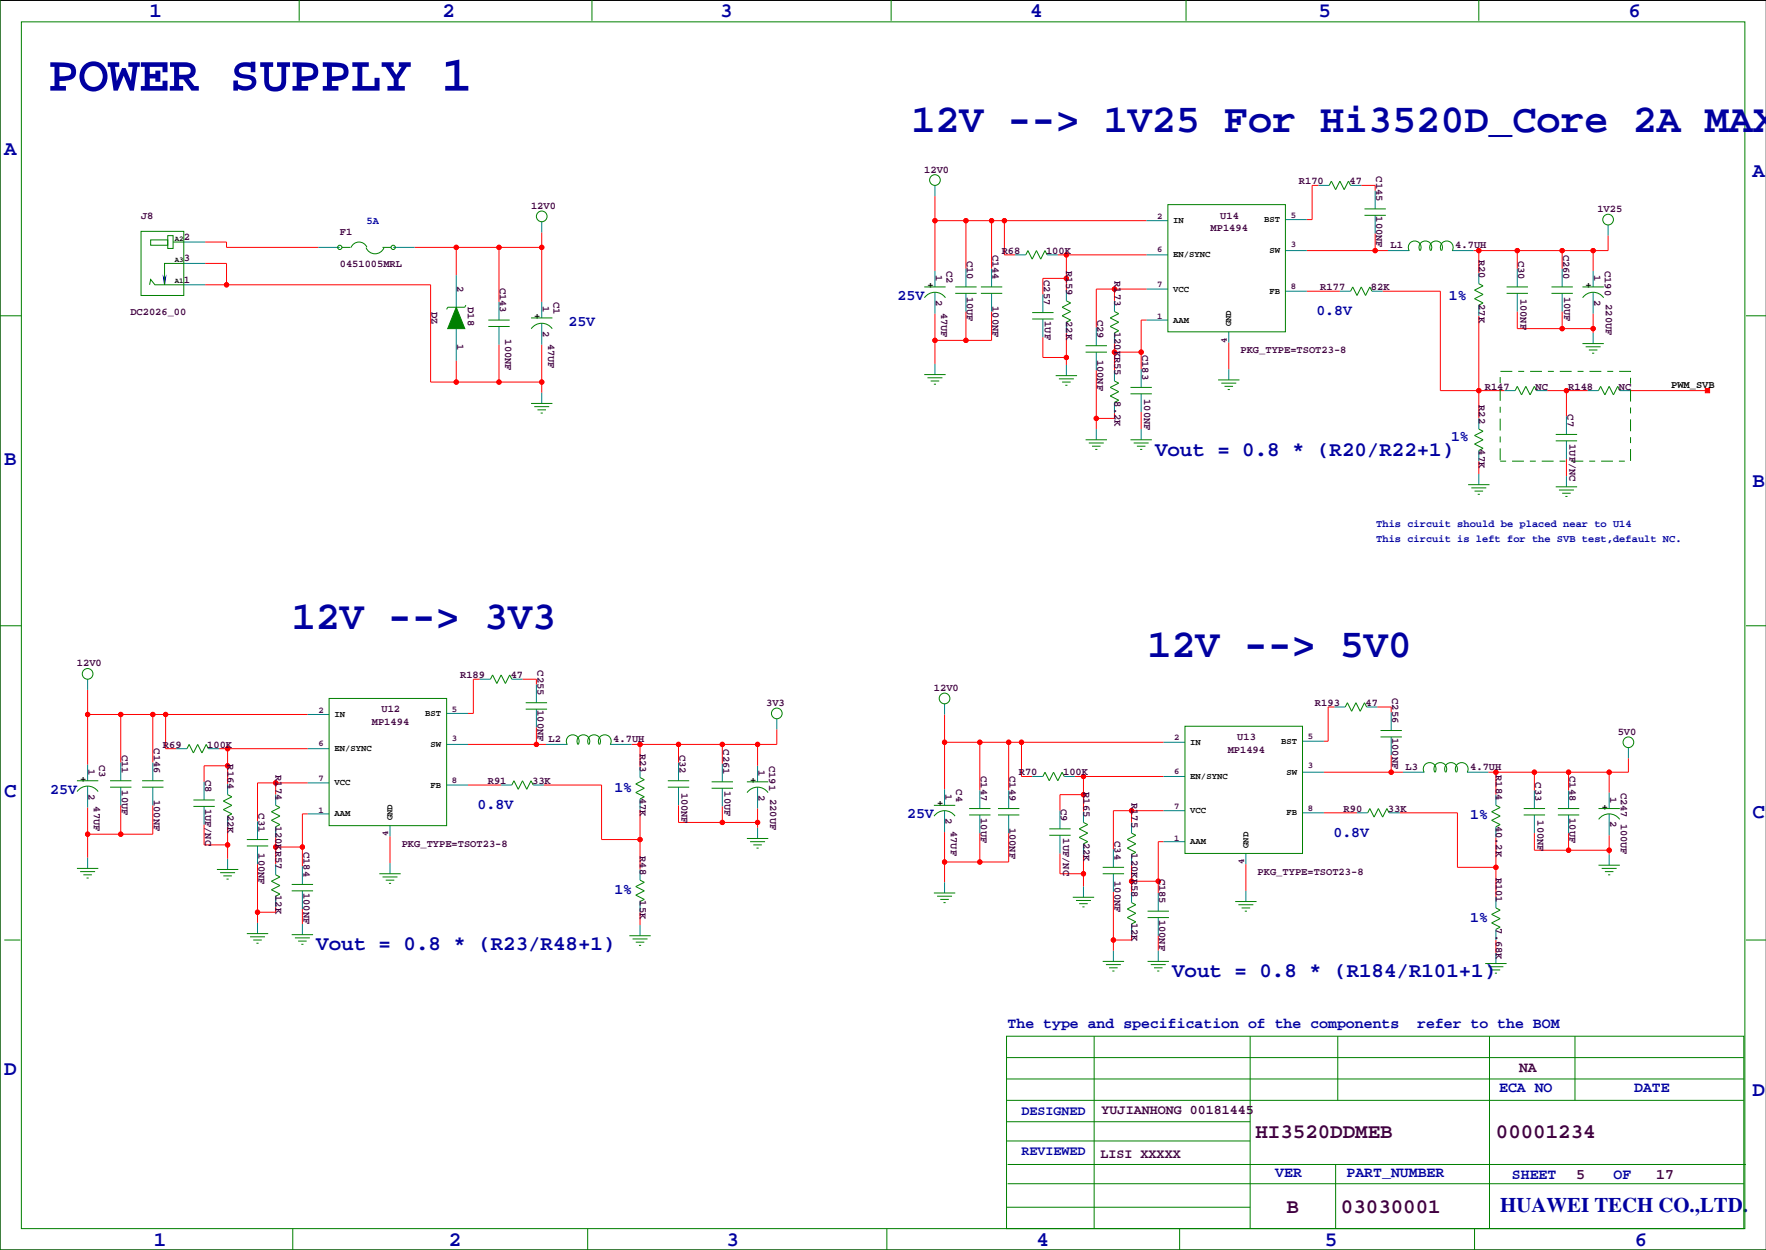
[picture p3: page 5]

This circuit should be placed near to U14
This circuit is left for the SVB test,default NC.

The type and specification of the components refer to the BOM

A

A

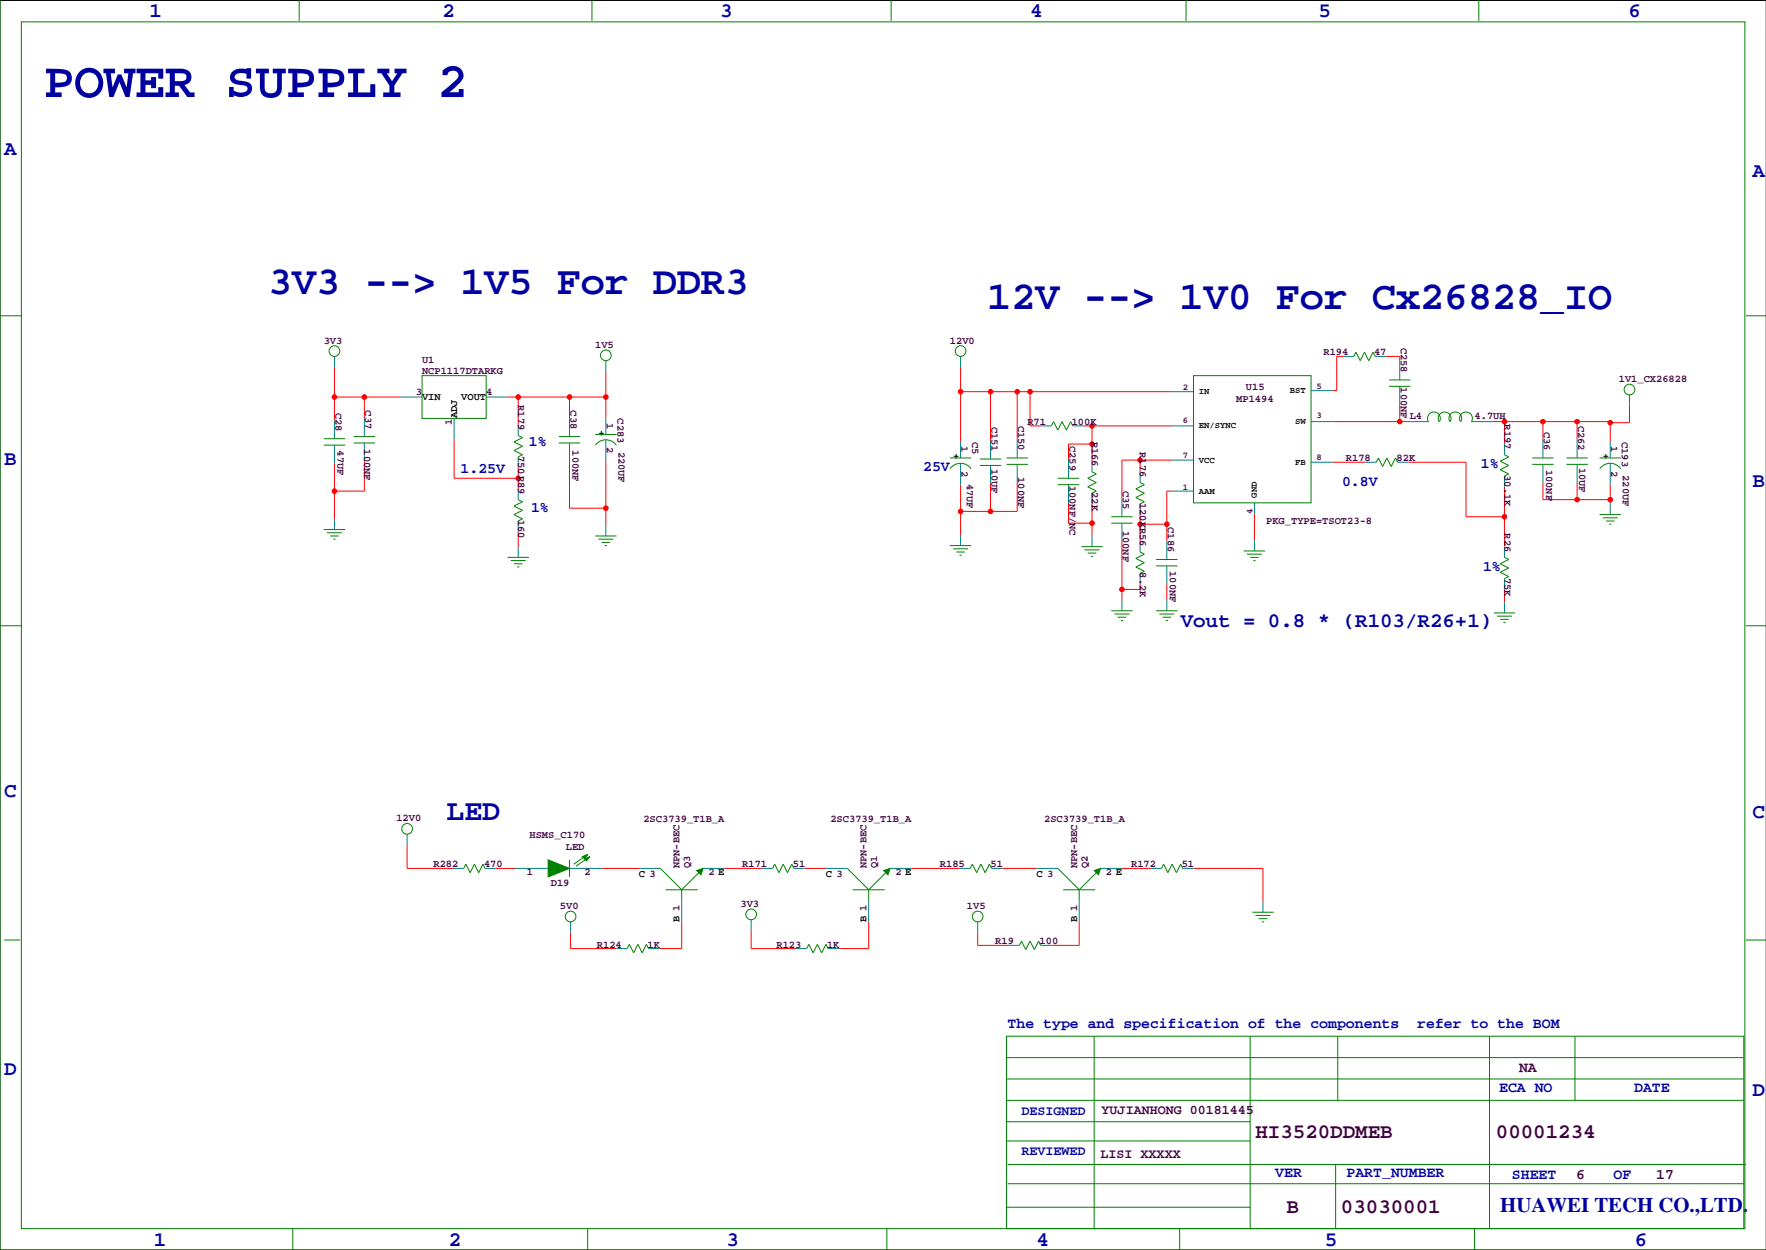
[picture p4: page 6]

The type and specification of the components refer to the BOM

A

A

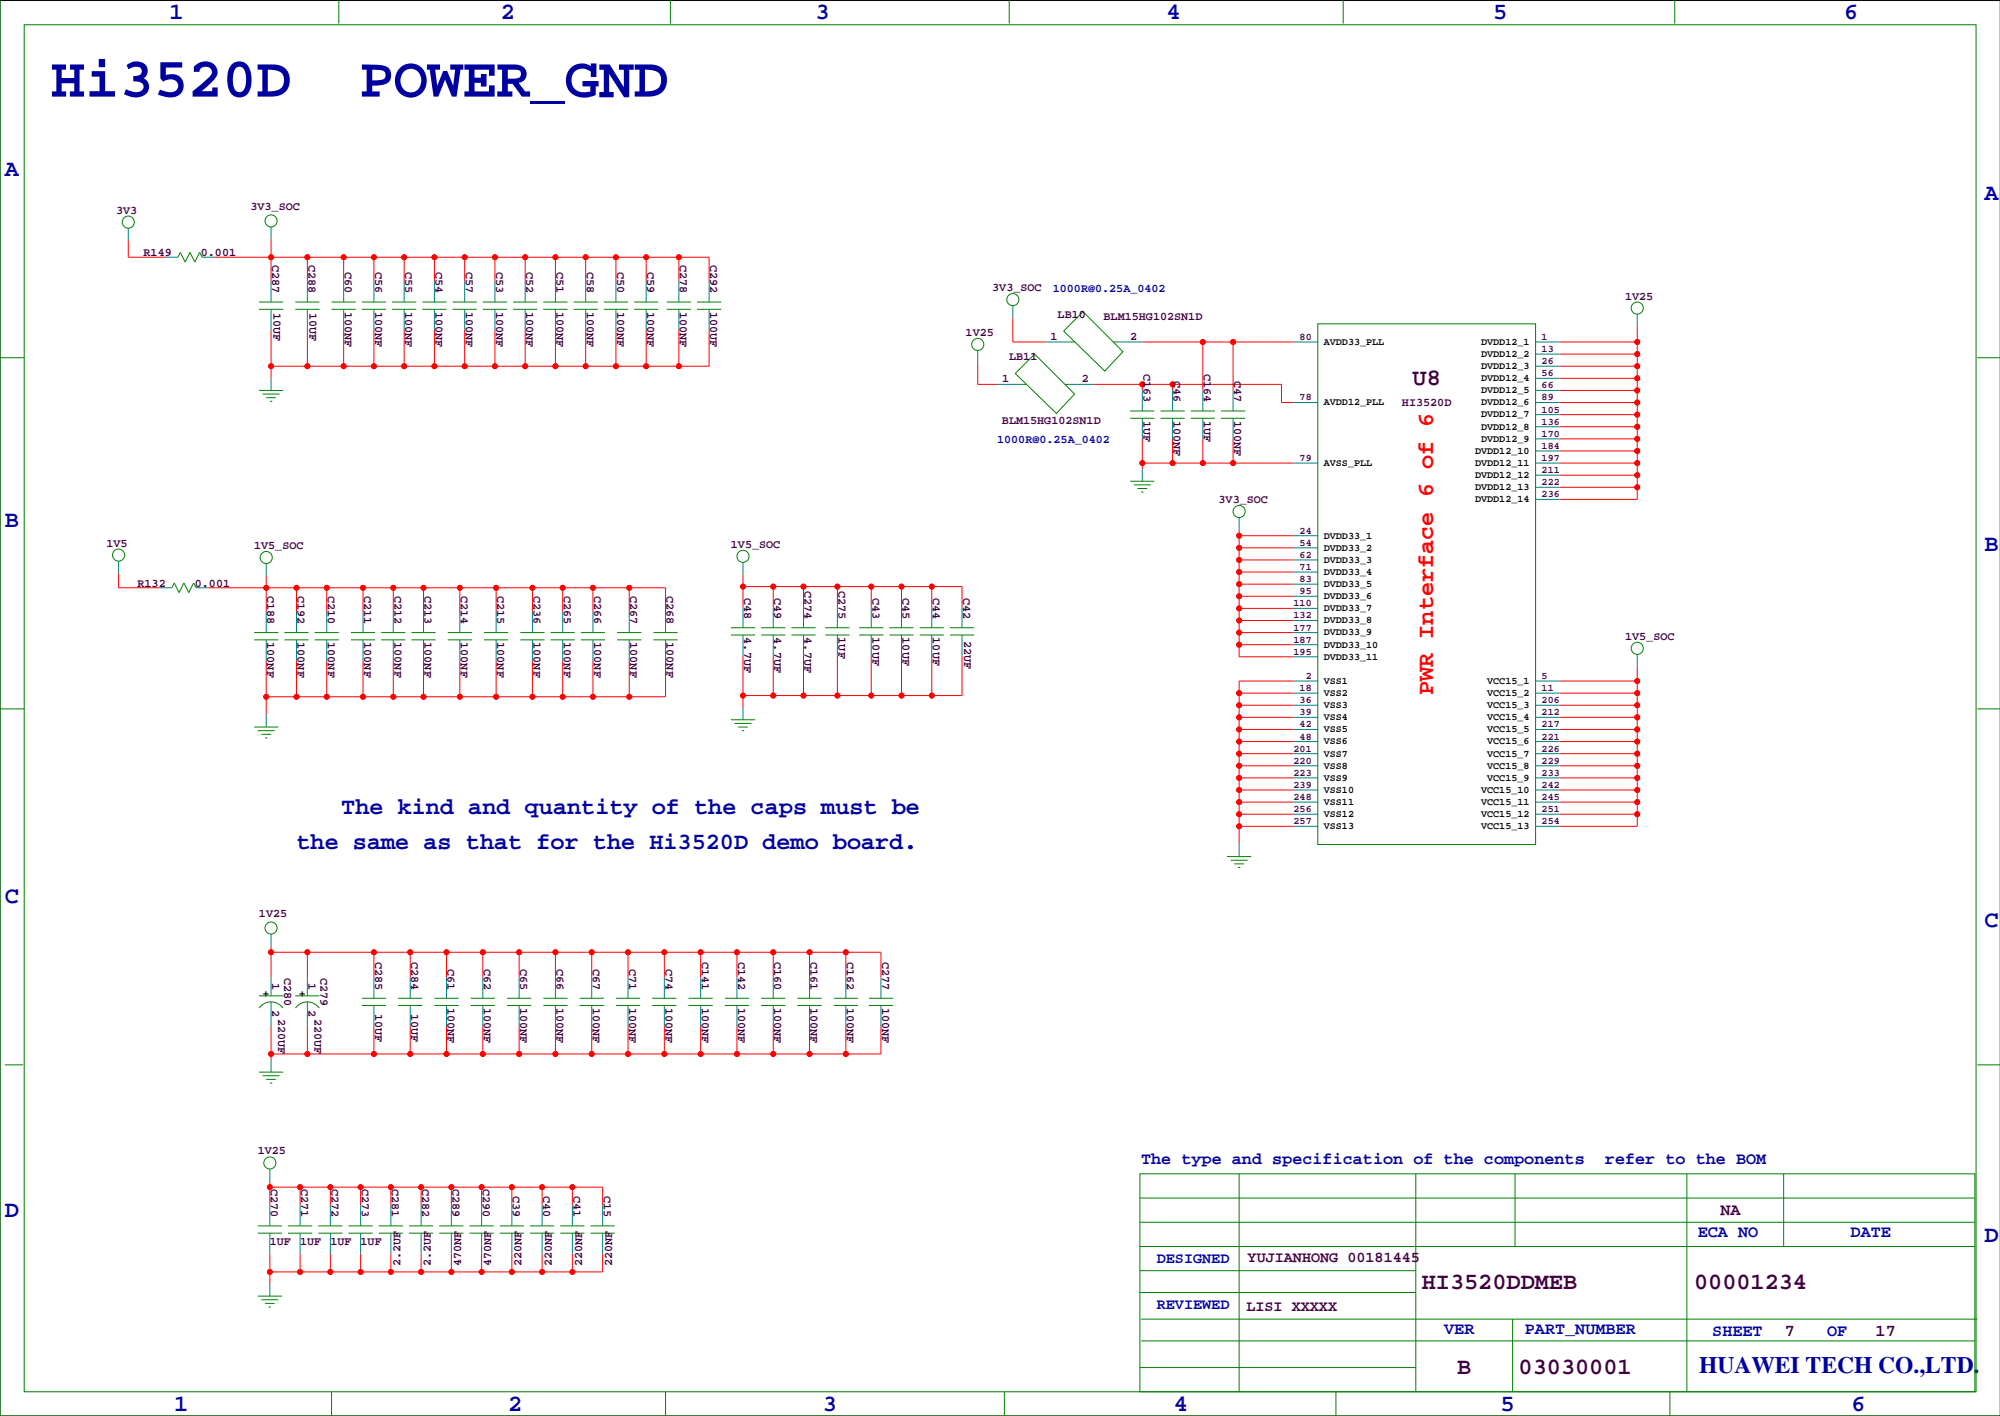
[picture p5: page 7]

The kind and quantity of the caps must be
the same as that for the Hi3520D demo board.

The type and specification of the components refer to the BOM

A

A

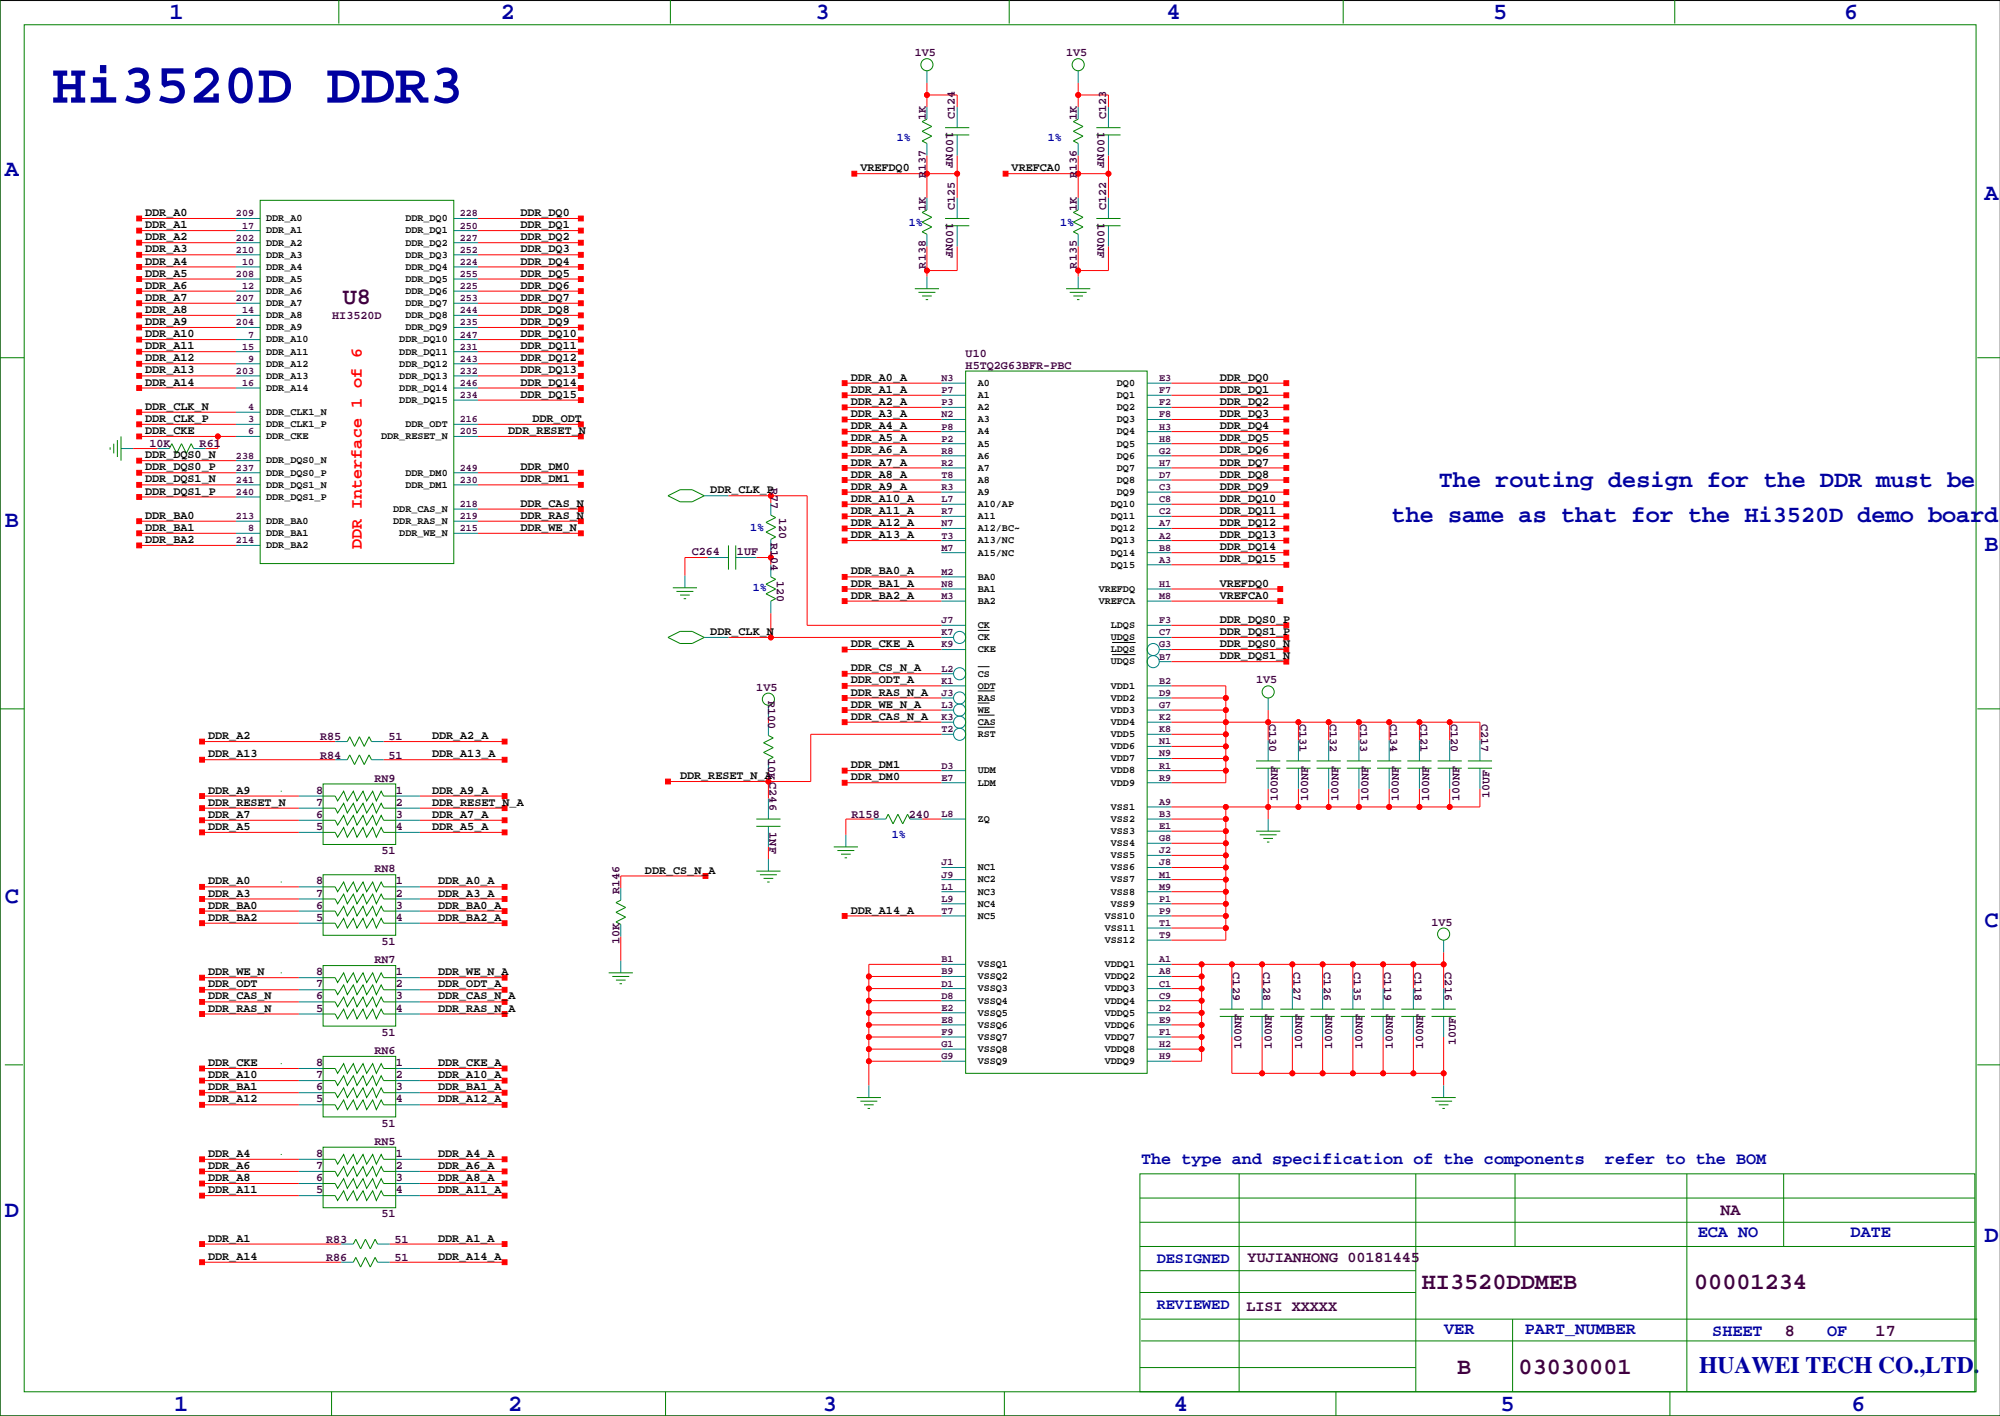
[picture p6: page 8]

The routing design for the DDR must be
the same as that for the Hi3520D demo board.

The type and specification of the components refer to the BOM

A

A

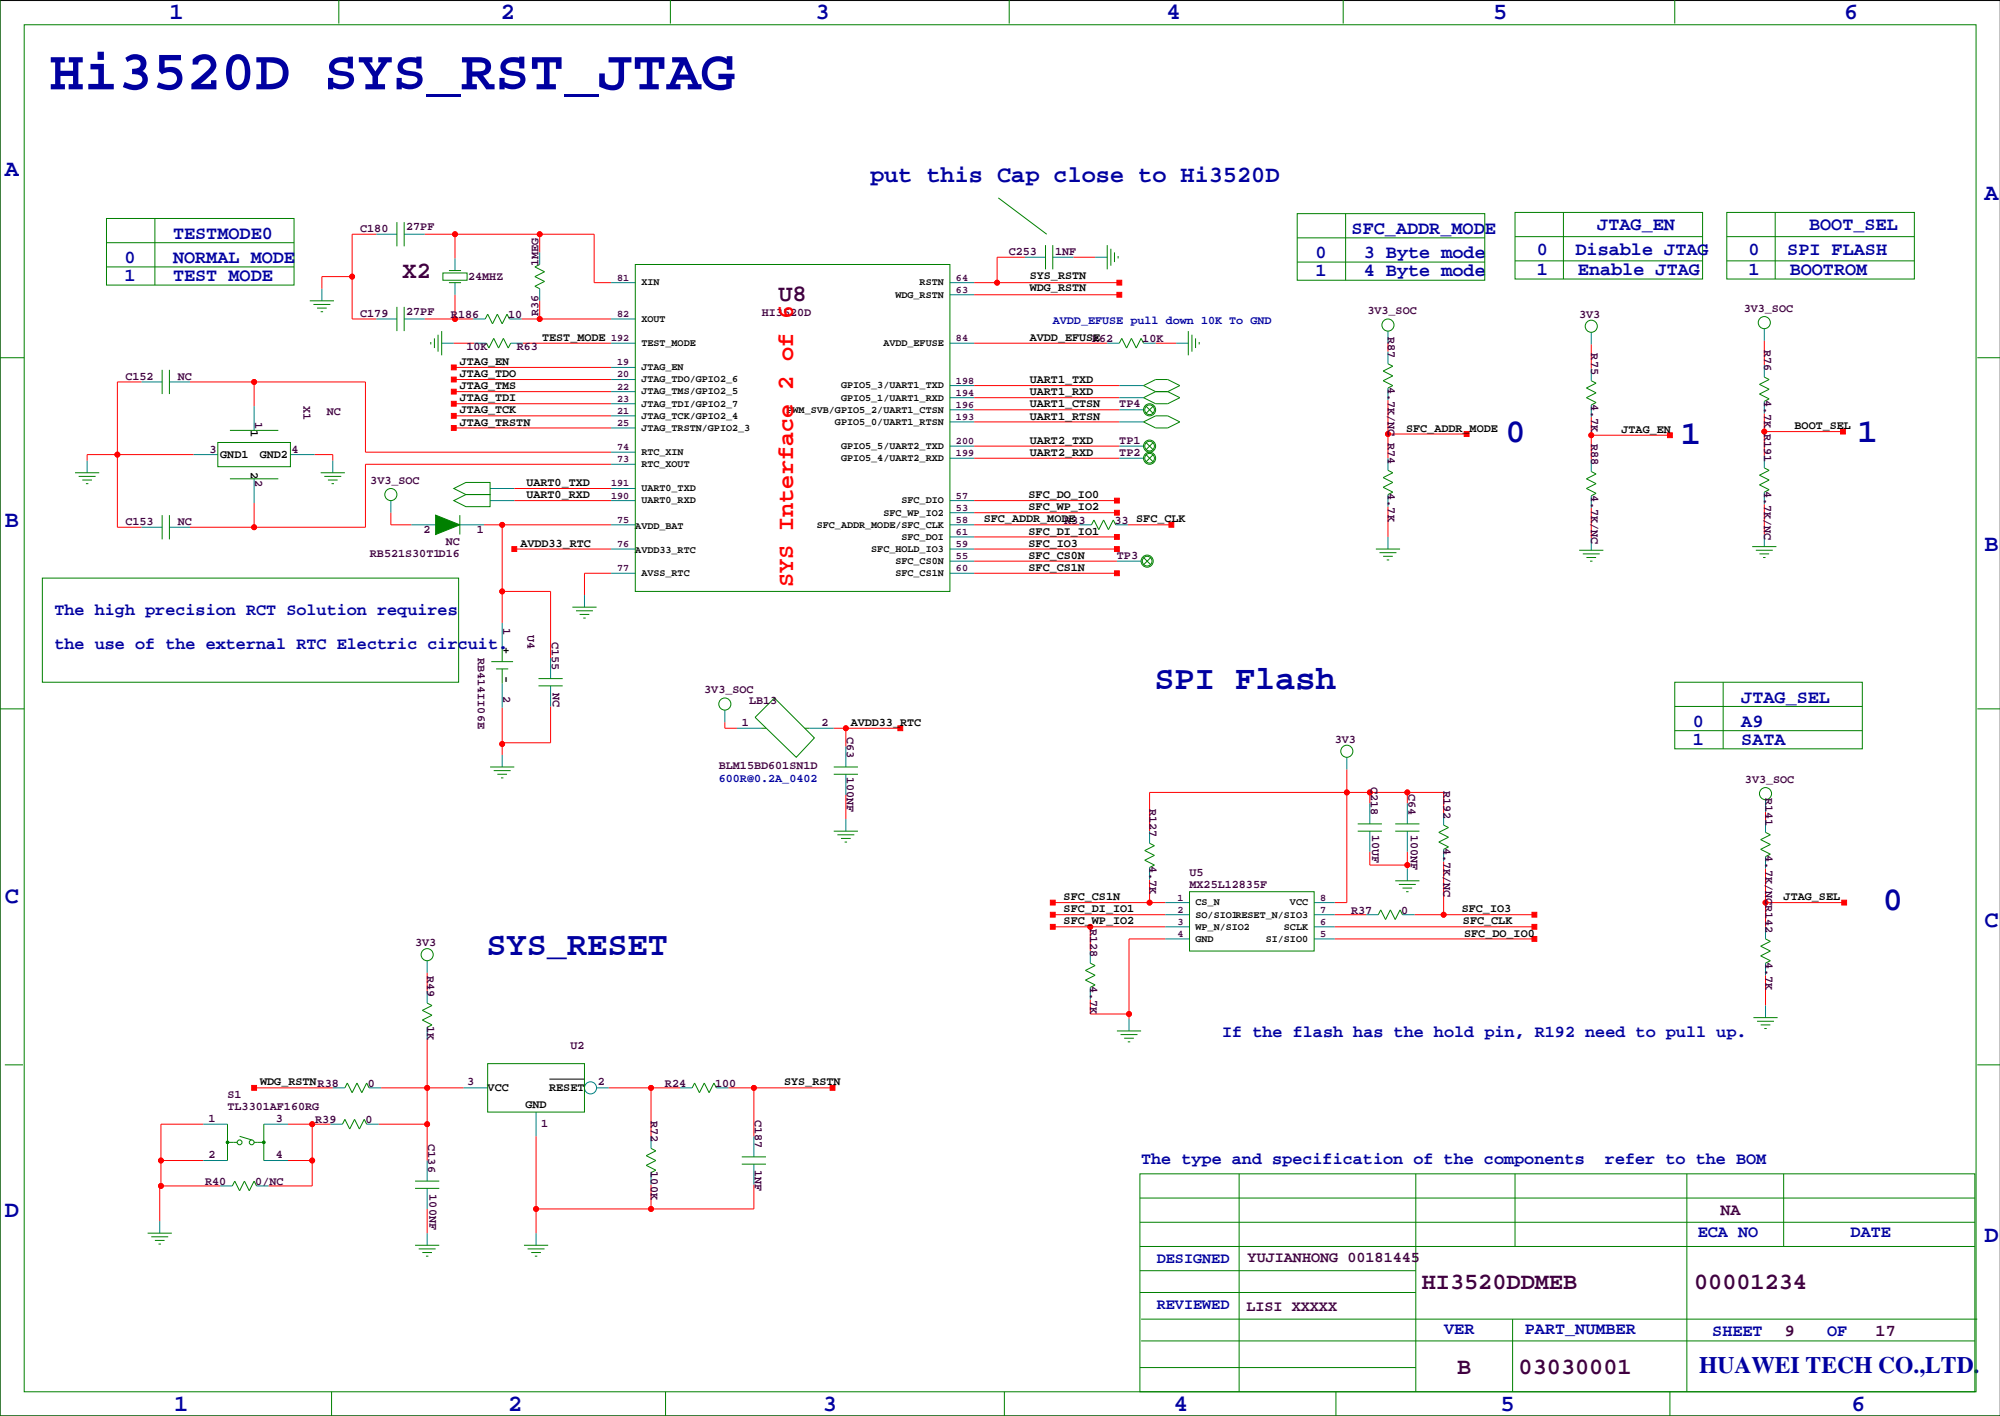
[picture p7: page 9]

put this Cap close to Hi3520D

AVDD_EFUSE pull down 10K To GND
AVDD_EFUSE

The high precision RCT Solution requires

the use of the external RTC Electric circuit.

If the flash has the hold pin, R192 need to pull up.

The type and specification of the components refer to the BOM

A

A

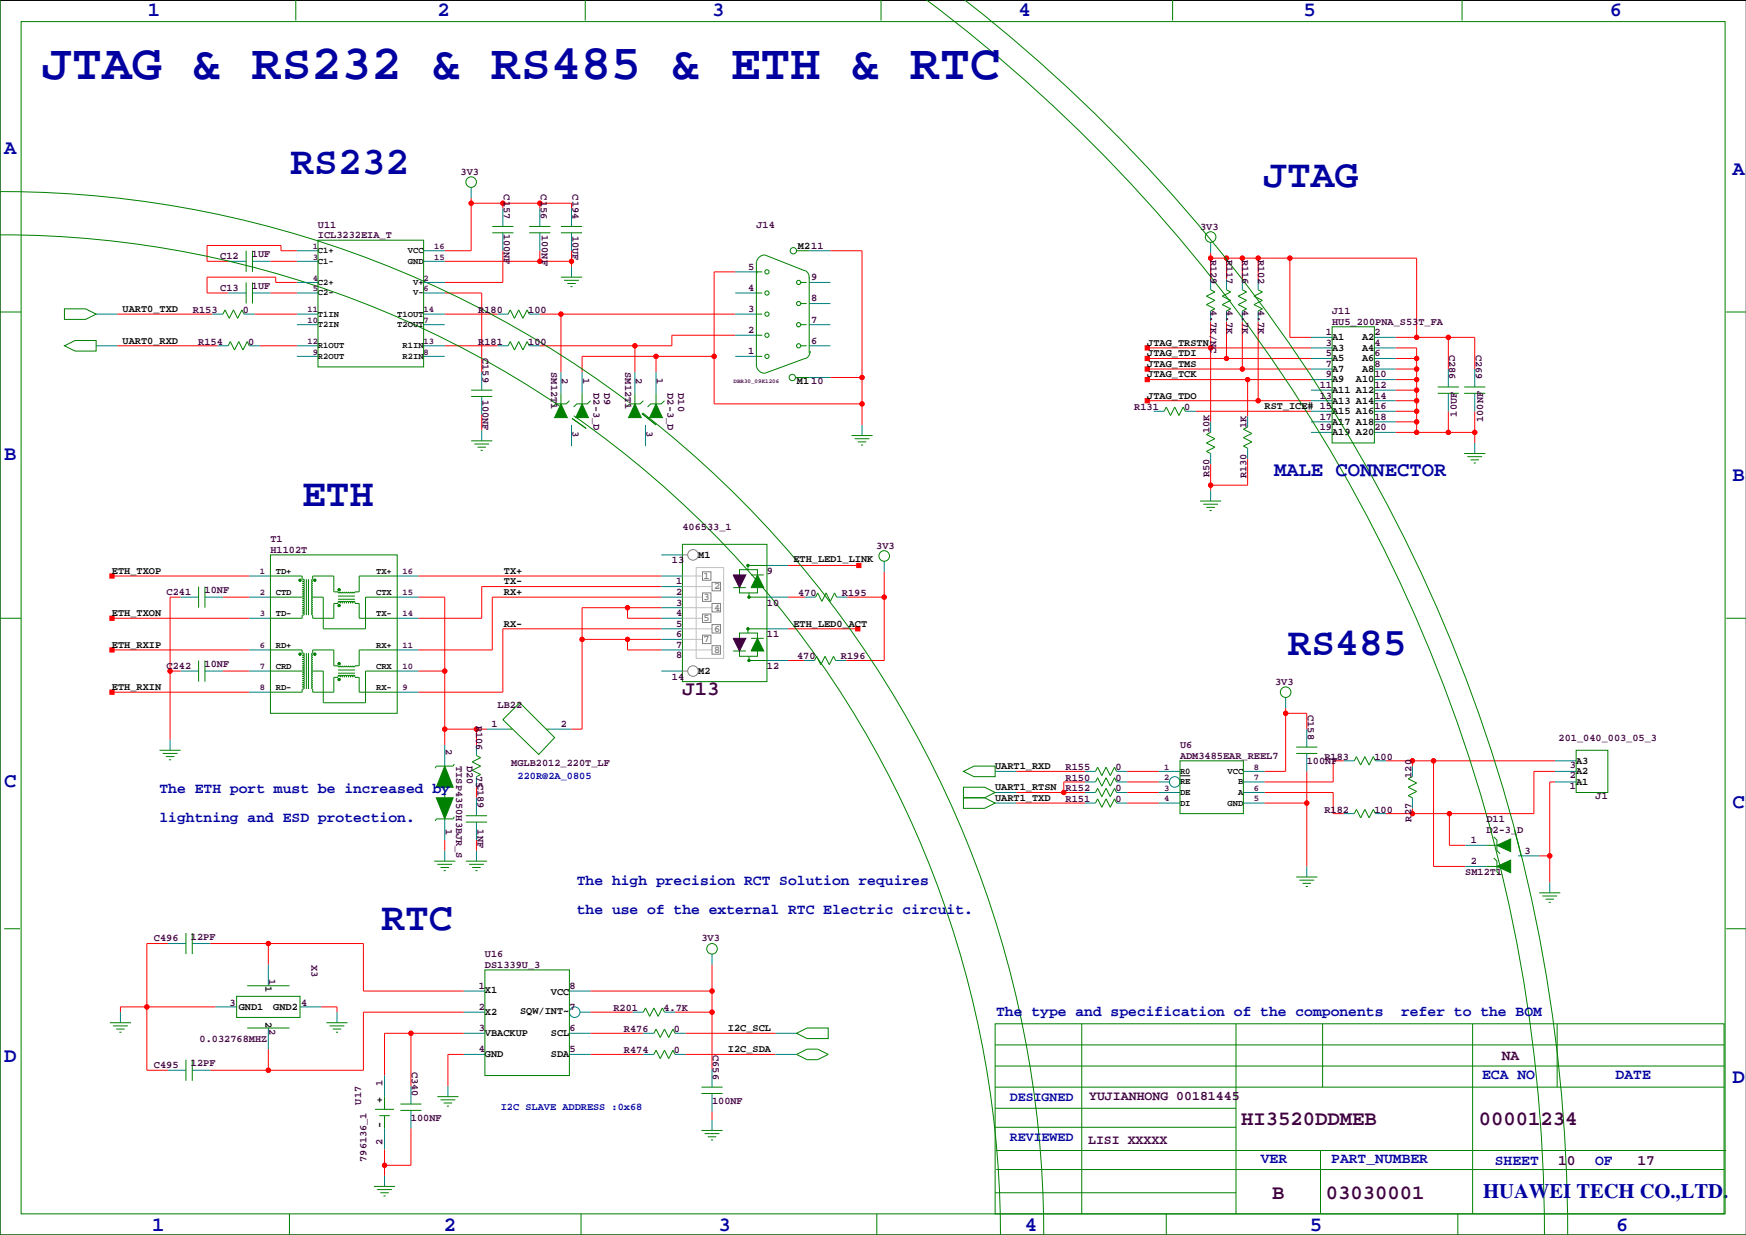
[picture p8: page 10]

The ETH port must be increased by

lightning and ESD protection.

The high precision RCT Solution requires

the use of the external RTC Electric circuit.

The type and specification of the components refer to the BOM

A

A

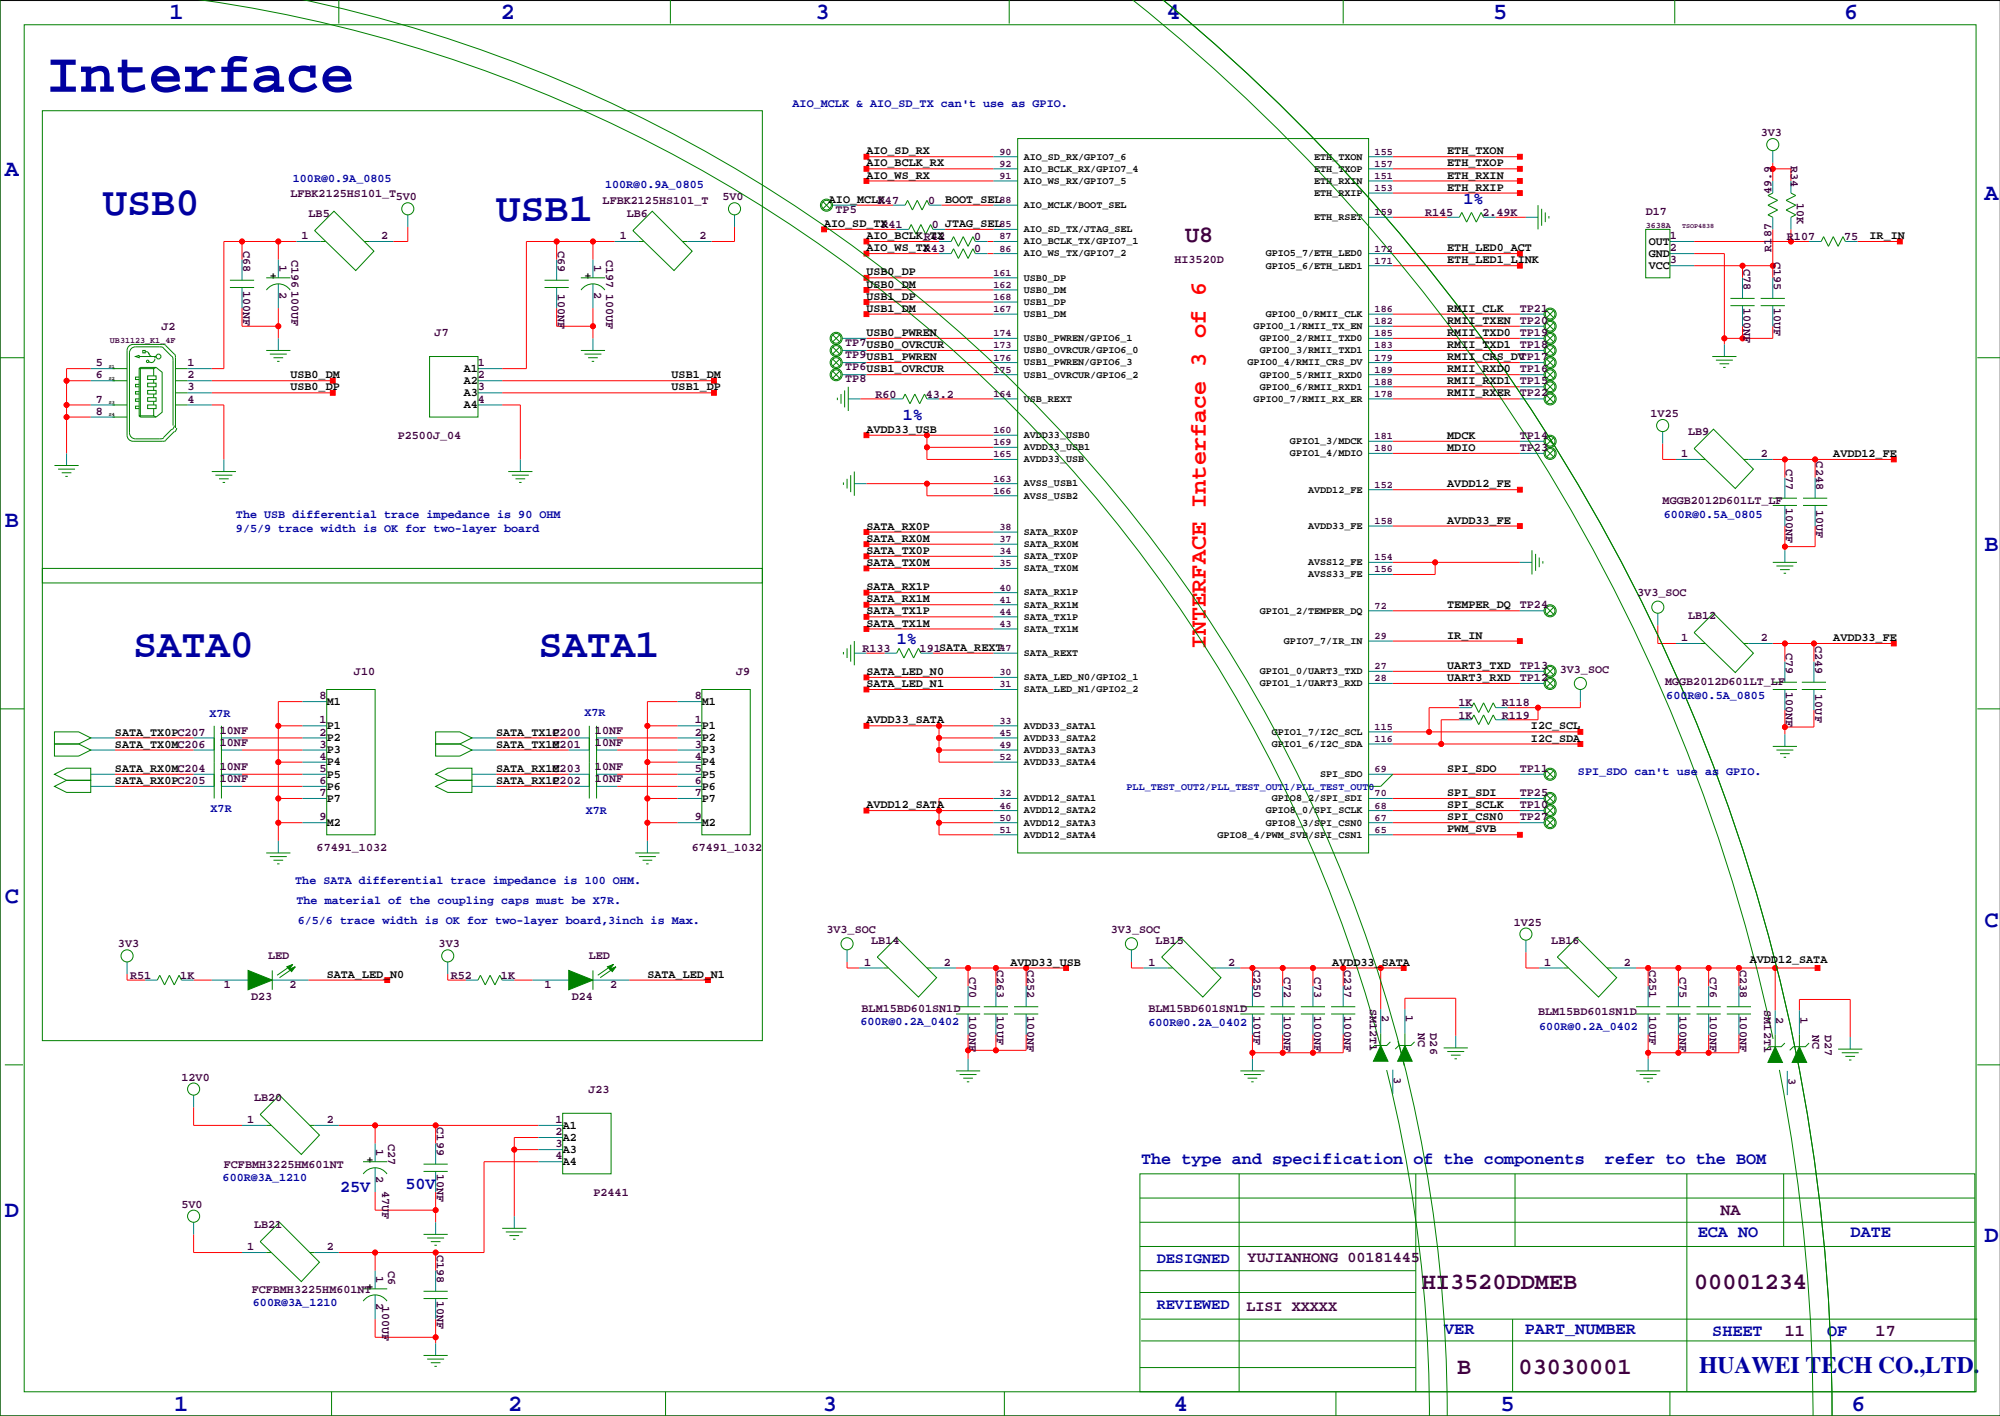
[picture p9: page 11]

AIO_MCLK & AIO_SD_TX can't use as GPIO.

The USB differential trace impedance is 90 OHM
9/5/9 trace width is OK for two-layer board

SPI_SDO can't use as GPIO.

The SATA differential trace impedance is 100 OHM.
The material of the coupling caps must be X7R.
6/5/6 trace width is OK for two-layer board,3inch is Max.

The type and specification of the components refer to the BOM

A

A

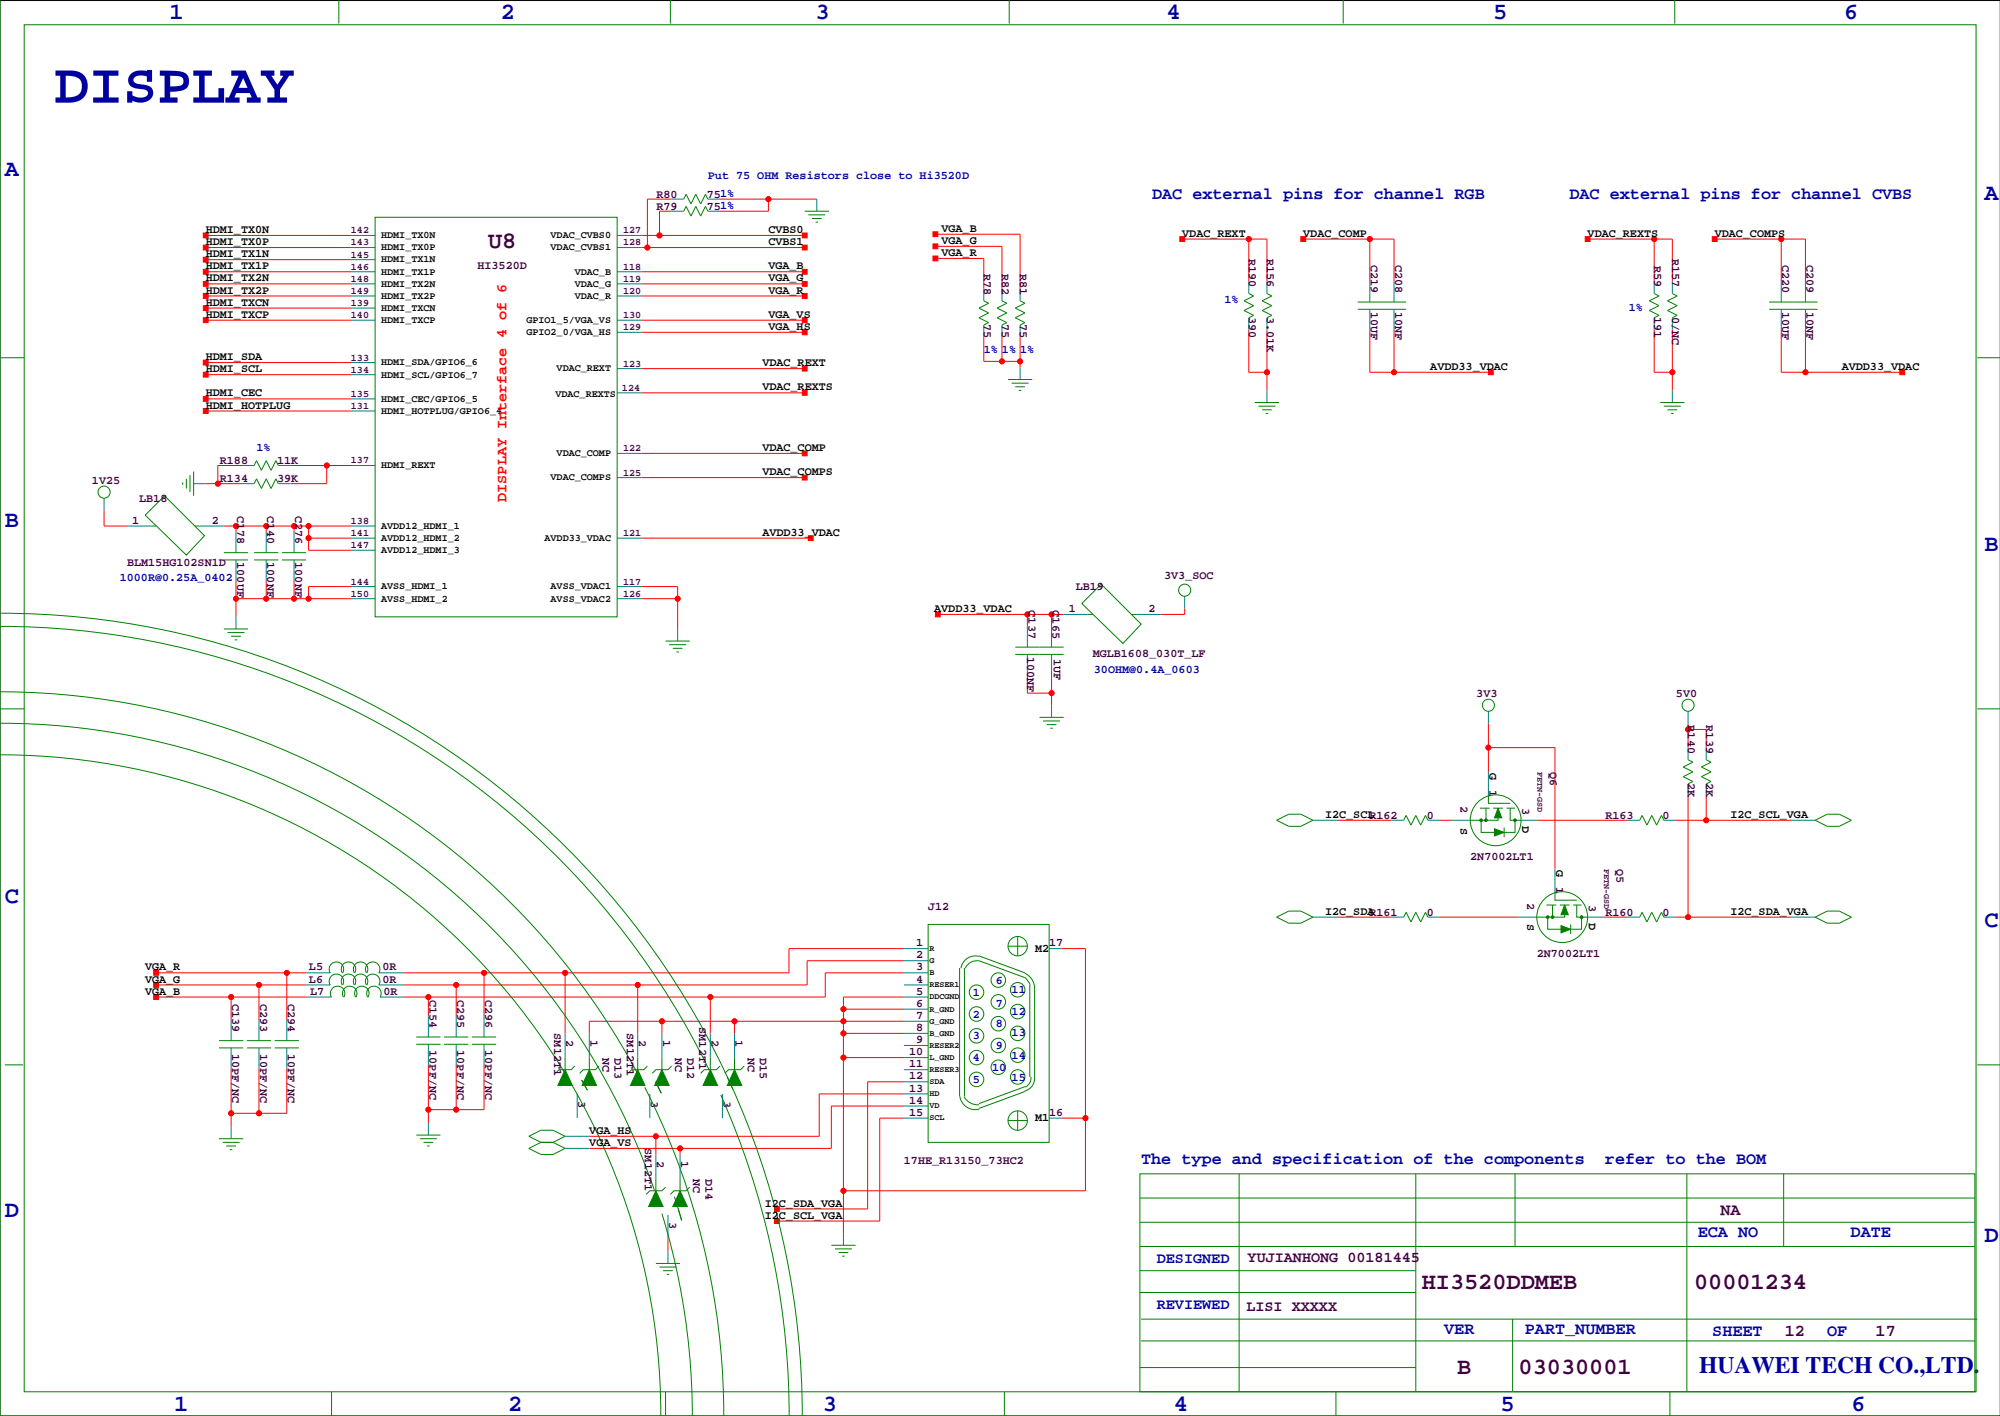
[picture p10: page 12]

The type and specification of the components refer to the BOM

A

A

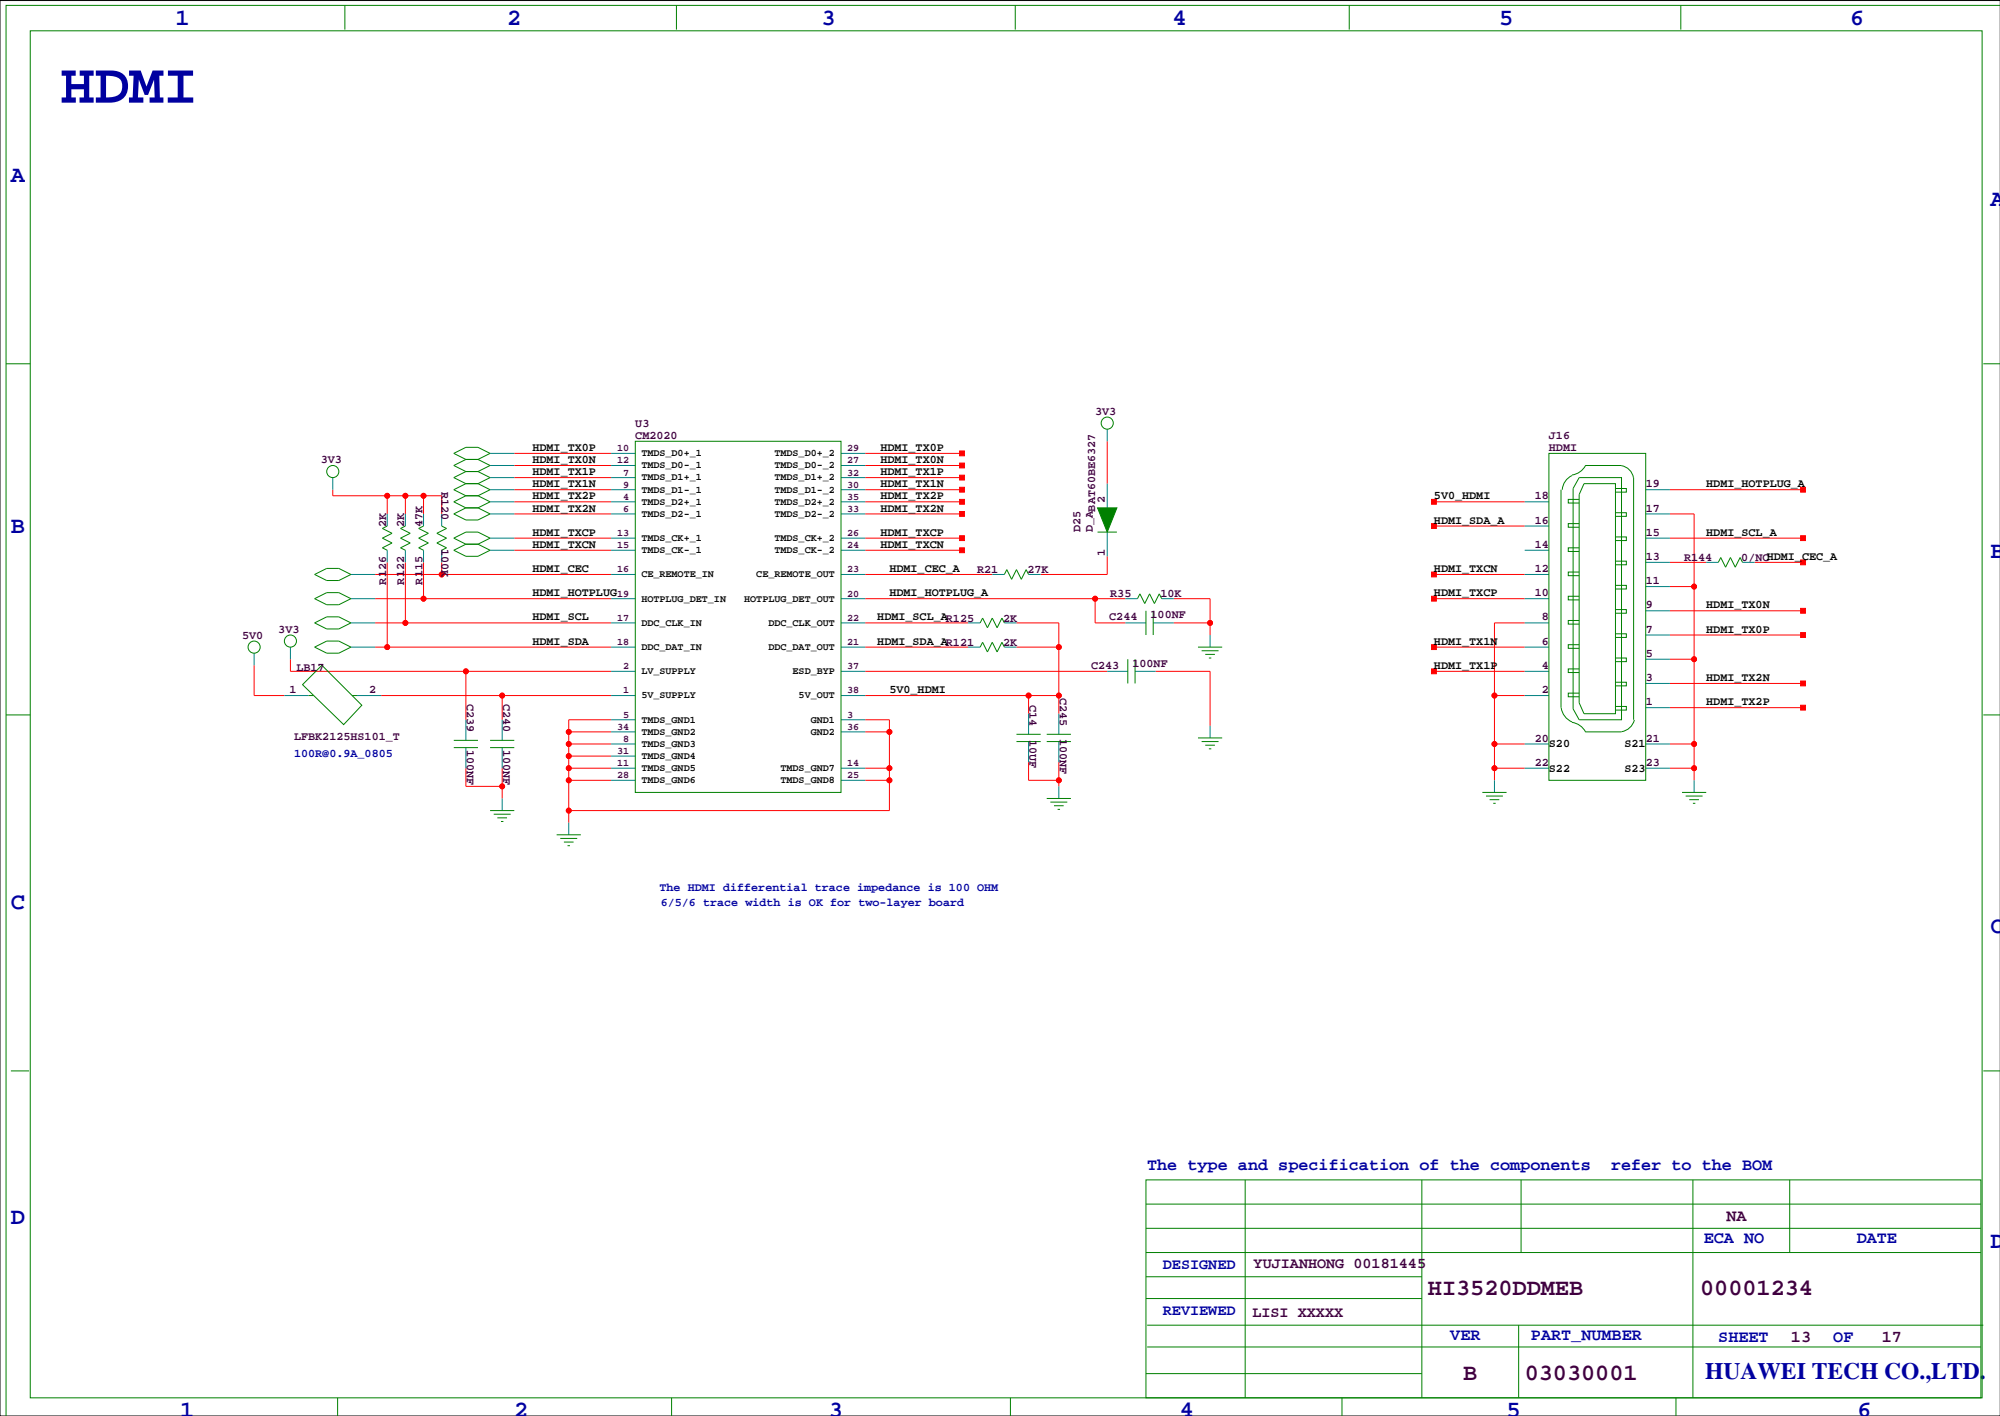
[picture p11: page 13]

The HDMI differential trace impedance is 100 OHM
6/5/6 trace width is OK for two-layer board

The type and specification of the components refer to the BOM

A

A

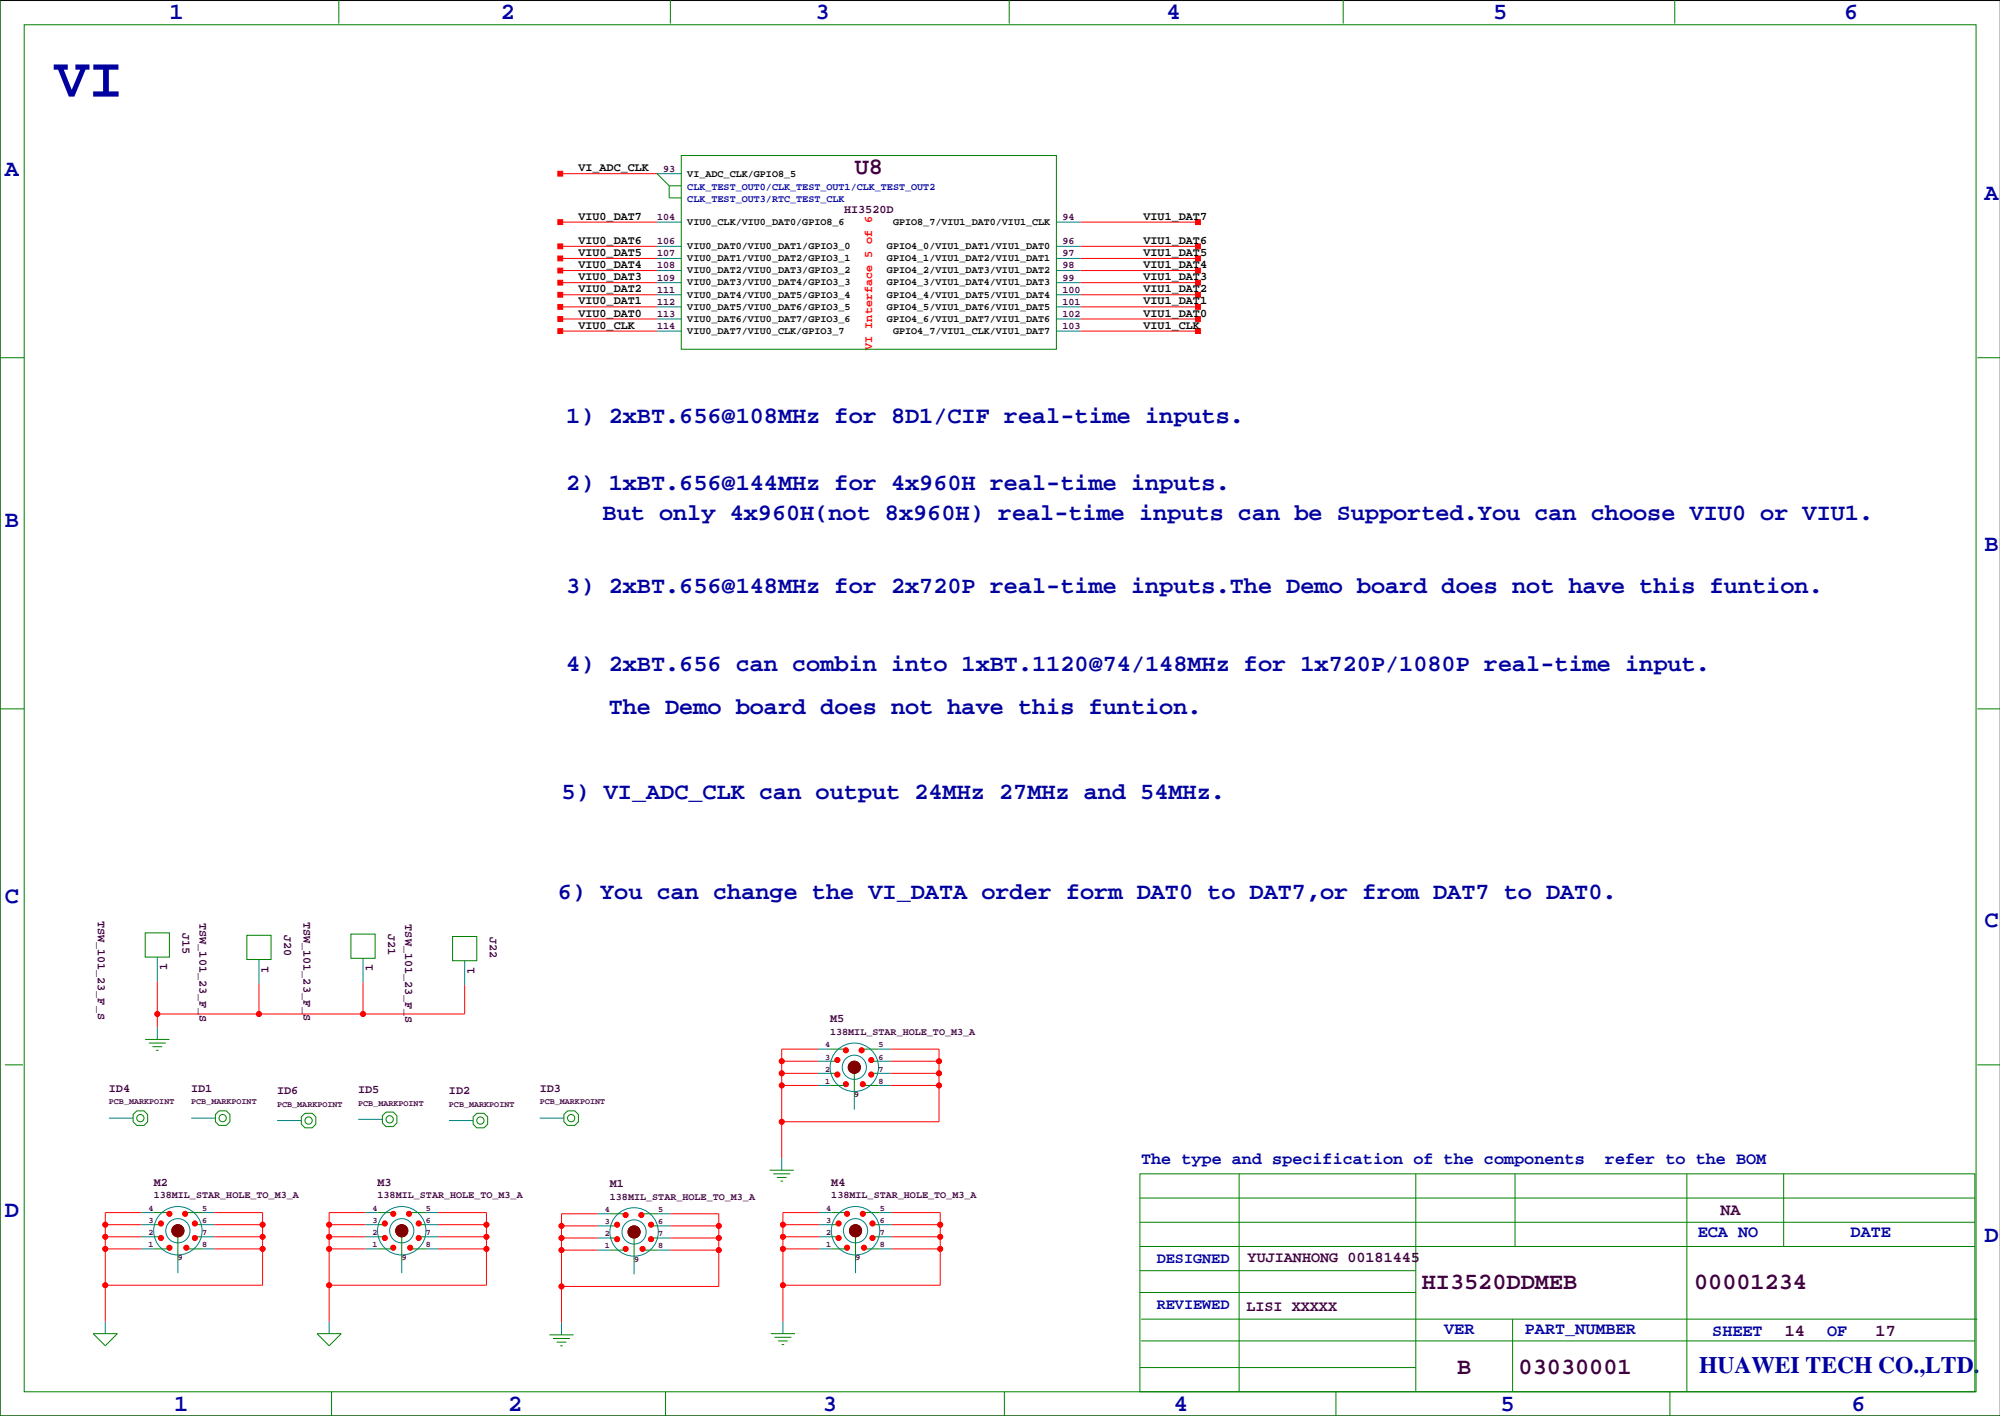
[picture p12: page 14]
DESIGNED; ECA NO; DATE; VI_ADC_CLK/GPIO8_5; GPIO8_7/VIU1_DAT0/VIU1_CLK; GPIO4_0/VIU1_DAT1/VIU1_DAT0 GPIO4_1/VIU1_DAT2/VIU1_DAT1 GPIO4_2/VIU1_DAT3/VIU1_DAT2 GPIO4_3/VIU1_DAT4/VIU1_DAT3 GPIO4_4/VIU1_DAT5/VIU1_DAT4 GPIO4_5/VIU1_DAT6/VIU1_DAT5 GPIO4_6/VIU1_DAT7/VIU1_DAT6 GPIO4_7/VIU1_CLK/VIU1_DAT7; VIU0_DAT1/VIU0_DAT2/GPIO3_1 VIU0_DAT2/VIU0_DAT3/GPIO3_2 VIU0_DAT3/VIU0_DAT4/GPIO3_3 VIU0_DAT4/VIU0_DAT5/GPIO3_4 VIU0_DAT5/VIU0_DAT6/GPIO3_5 VIU0_DAT6/VIU0_DAT7/GPIO3_6 VIU0_DAT7/VIU0_CLK/GPIO3_7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

1) 2xBT.656@108MHz for 8D1/CIF real-time inputs.

2) 1xBT.656@144MHz for 4x960H real-time inputs.
But only 4x960H(not 8x960H) real-time inputs can be Supported.You can choose VIU0 or VIU1.

3) 2xBT.656@148MHz for 2x720P real-time inputs.The Demo board does not have this funtion.

4) 2xBT.656 can combin into 1xBT.1120@74/148MHz for 1x720P/1080P real-time input.
The Demo board does not have this funtion.

5) VI_ADC_CLK can output 24MHz 27MHz and 54MHz.

6) You can change the VI_DATA order form DAT0 to DAT7,or from DAT7 to DAT0.

The type and specification of the components refer to the BOM

A

A

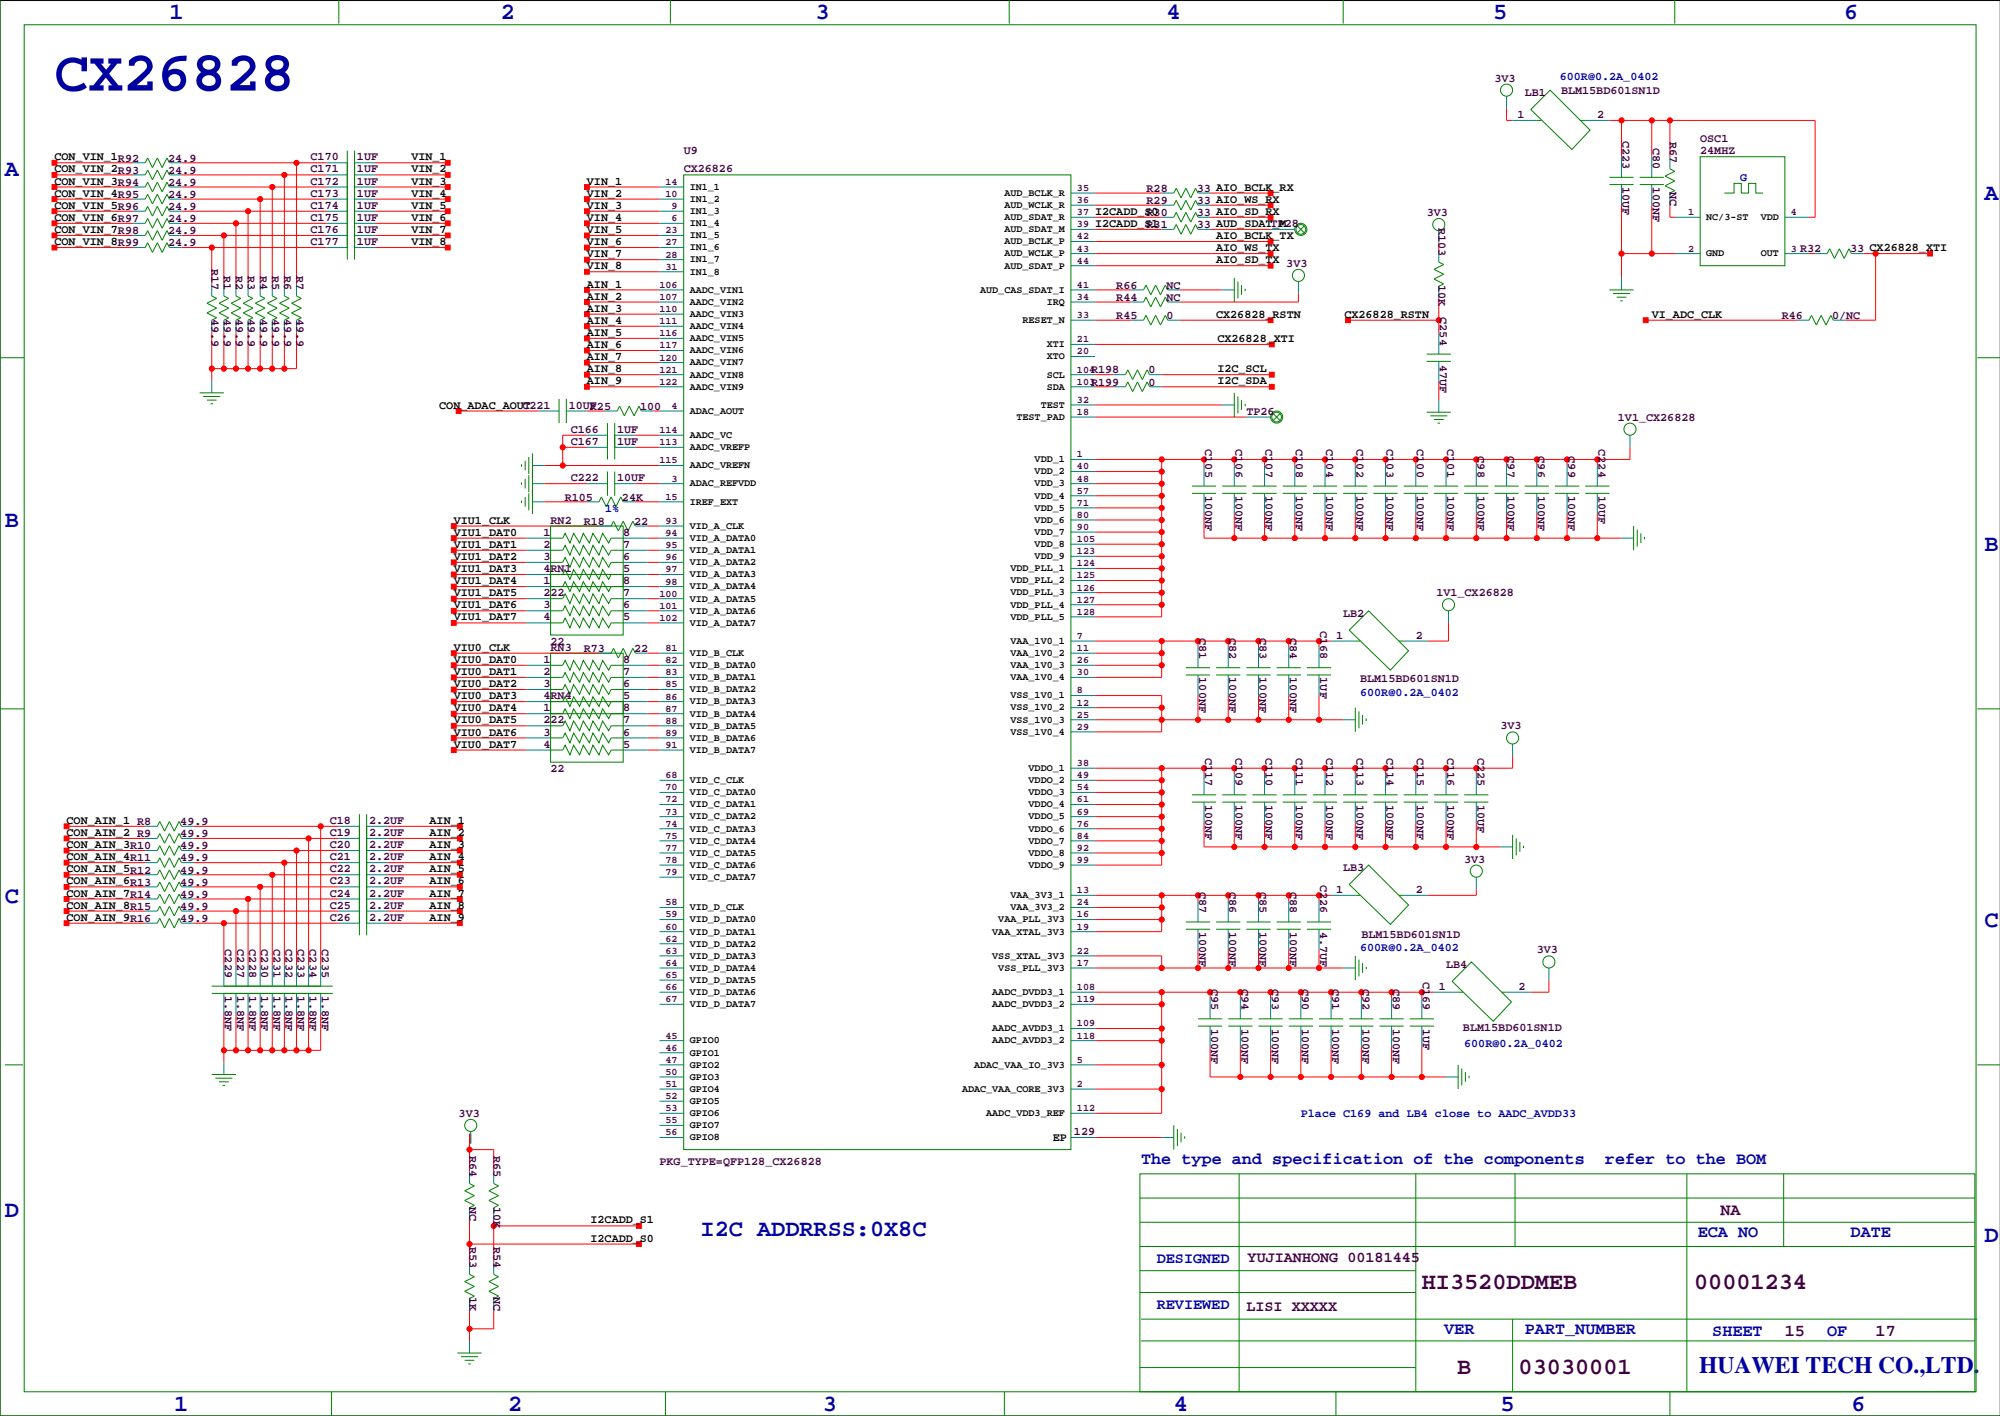
[picture p13: page 15]

Place C169 and LB4 close to AADC_AVDD33

The type and specification of the components refer to the BOM

A

A

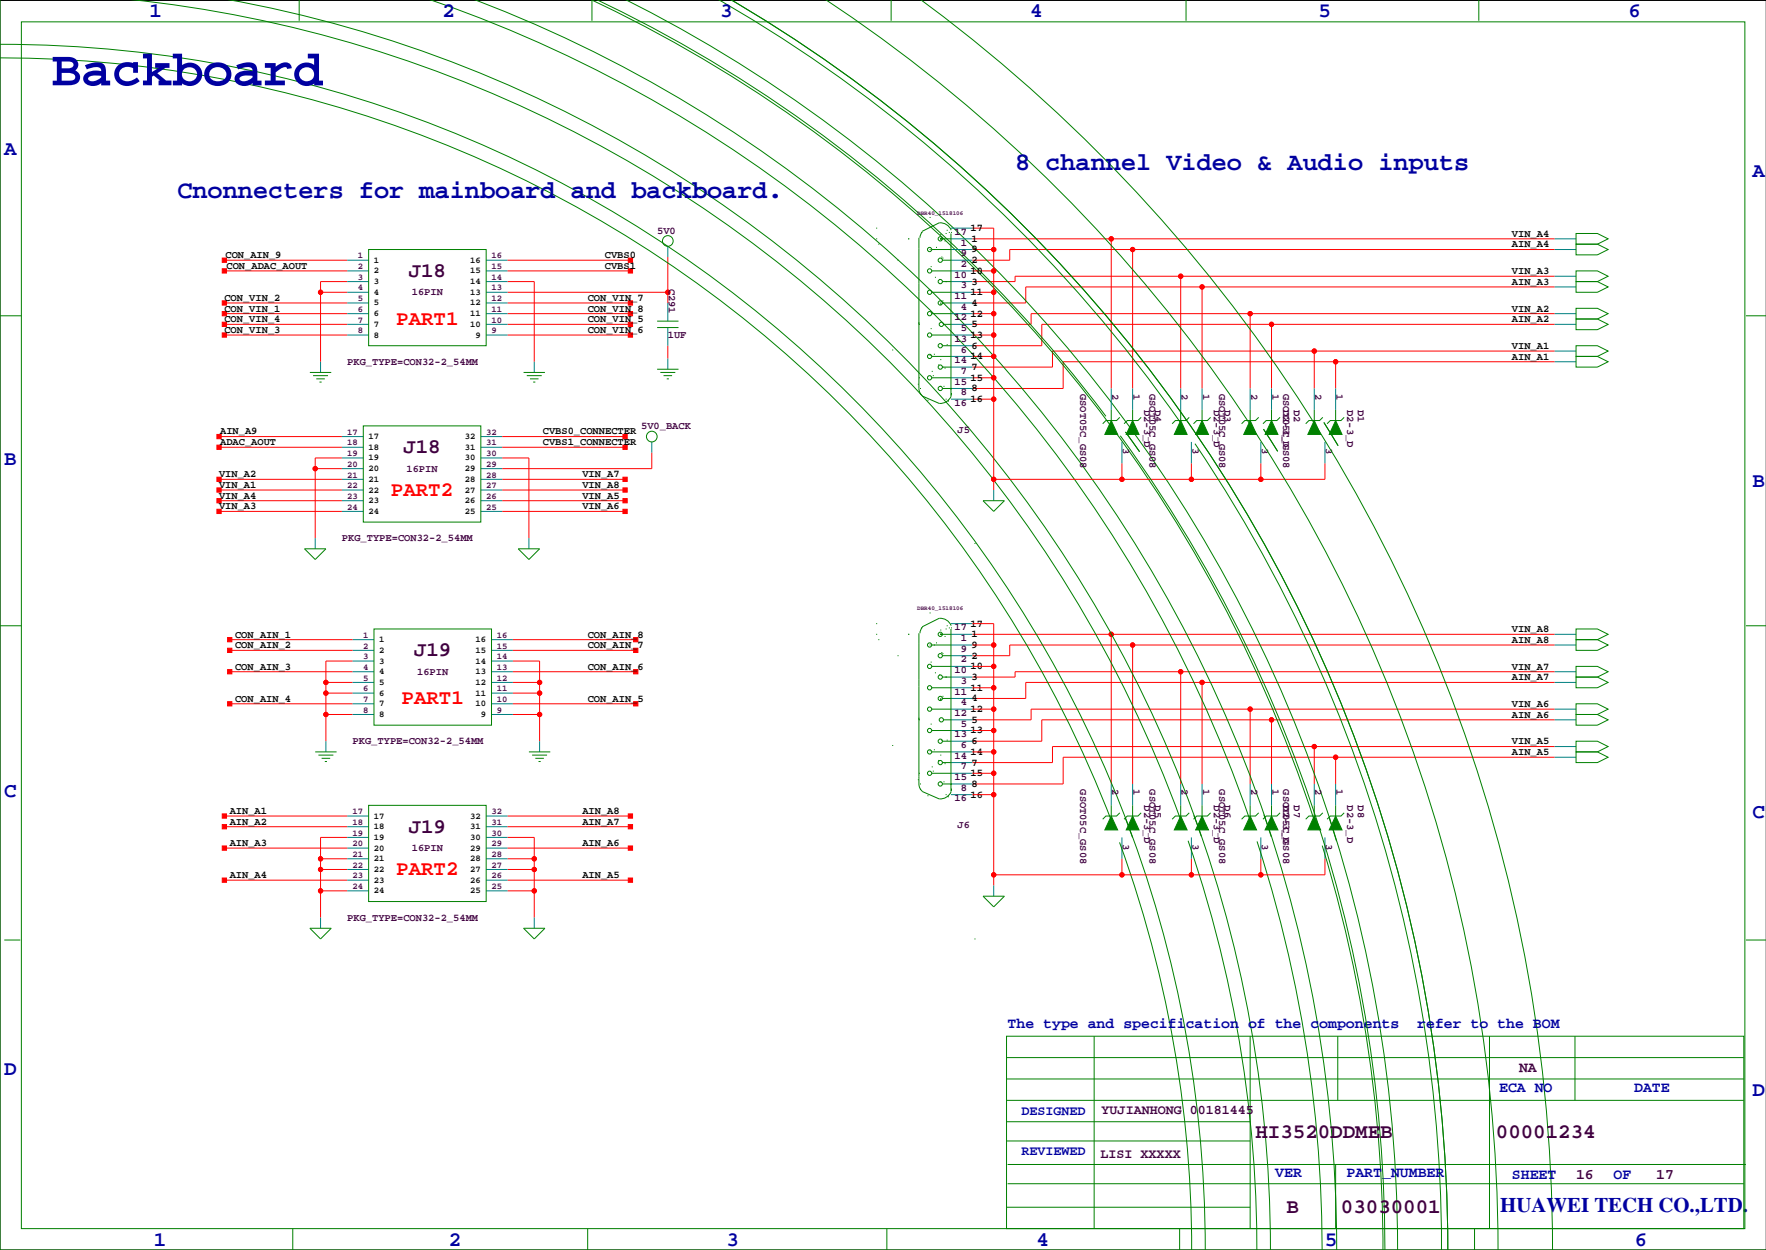
[picture p14: page 16]

8 channel Video & Audio inputs

Cnonnecters for mainboard and backboard.

The type and specification of the components refer to the BOM

A

A

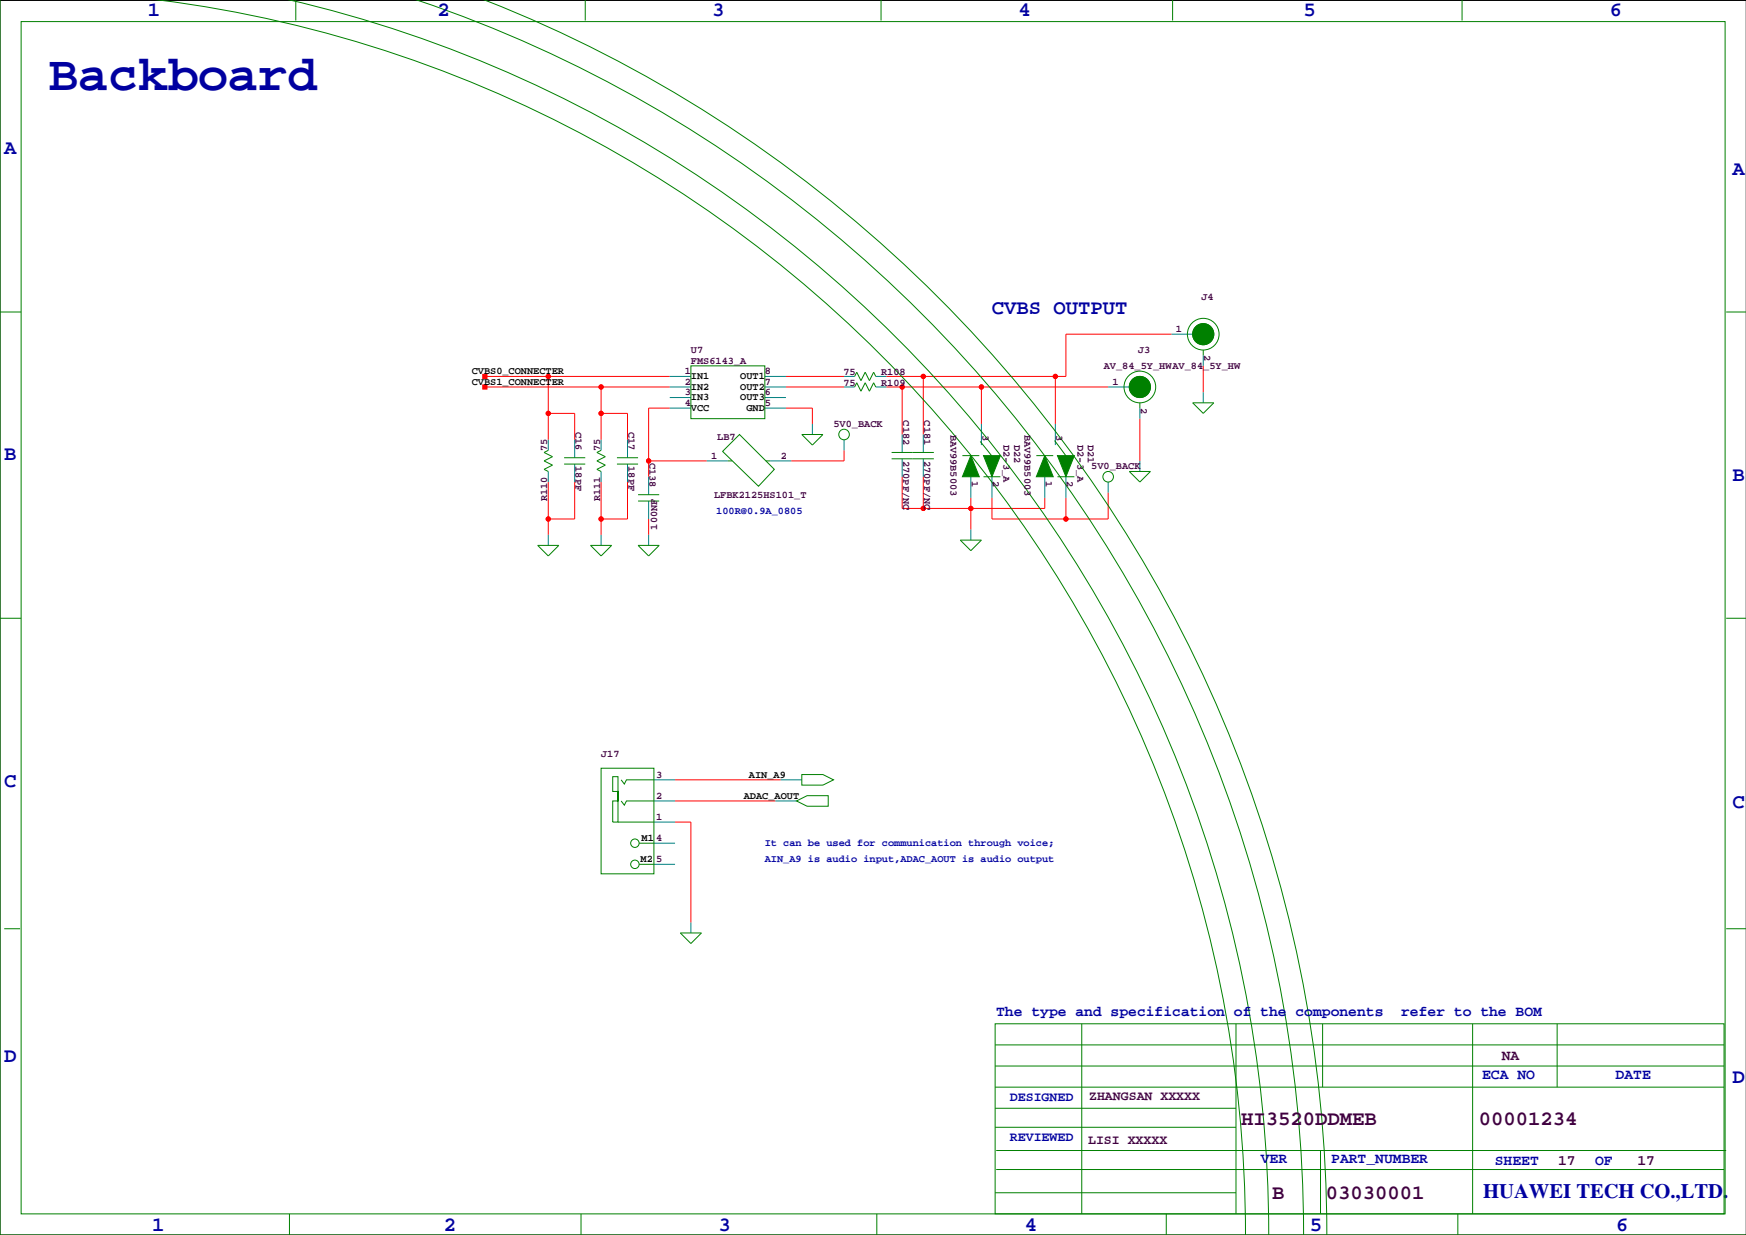
[picture p15: page 17]

It can be used for communication through voice;
AIN_A9 is audio input,ADAC_AOUT is audio output

The type and specification of the components refer to the BOM
