rgmabs19357/Hi3520D_V100R001C01SPC022/(list of files, drawings)

Other design files:
00.hardware/board/HI3520DDMEB VER_B.DSN
