rgmabs19357/Hi3520D_V100R001C01SPC022/(commit log)

2015-06-02 Add Hi3520D V100R001C01SPC022 version release notes files.
    [Hi3515A V100R001 Deliverable List.xls, Hi3515A V100R001 交付件清单.xls, Hi3515C V100R001 Deliverable List.xls, Hi3515C V100R001 交付件清单.xls, Hi3520D V100R001 Deliverable List.xls, Hi3520D V100R001 交付件清单.xls]
2015-06-02 Add Hi3520D V100R001C01SPC022 hardware files.
    [HI3520DDMEB VER_B.DSN, HI3520DDMEB_VER_B_BOM.xlsx, HI3520DDMEB_VER_B_BOM_EN.xlsx]
2015-06-06 Add Hi3520D V100R001C01SPC022 board software documents.
